dash-orlando/AugmentedStethoscope/Software/Sound Library/YouTube Videos/YouTube Videos.docx

https://www.youtube.com/watch?v=bHXvhOQ0hYc

https://www.youtube.com/watch?v=UfCr_wUepxo

https://www.youtube.com/watch?v=MCtoqxRfBi4

https://www.youtube.com/watch?v=KnYfreaRQe4

YouTube Videos Blood Pressure Sounds
