dash-orlando/AugmentedStethoscope/Documentation/Conferences/DMD/2018/paper_figures.pptx

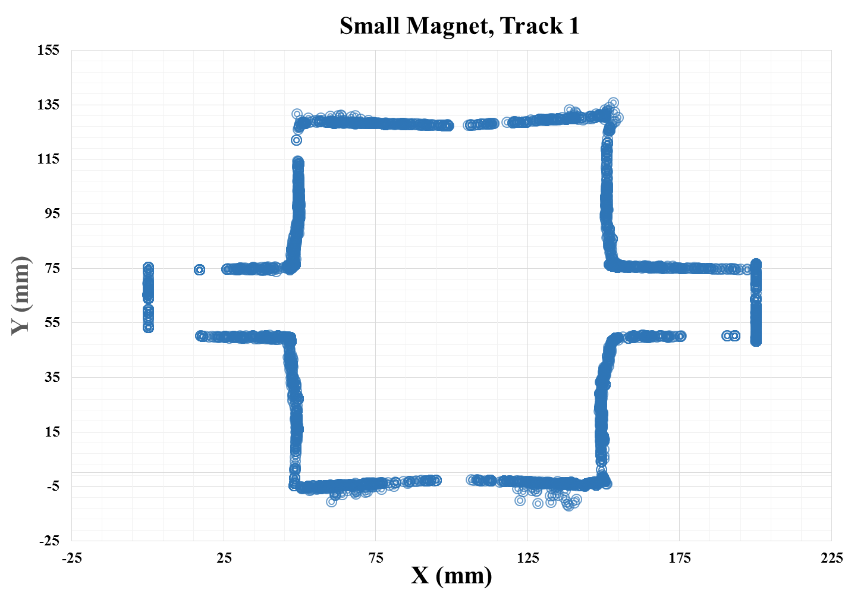
[picture p10: figure]
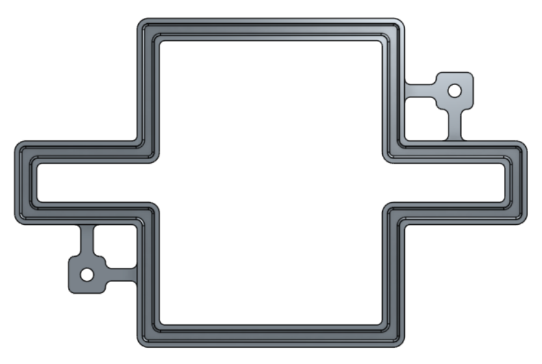
[picture p11: figure]

## Slide 2

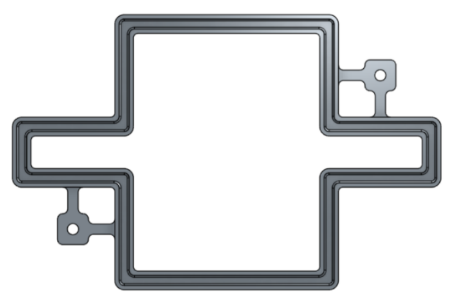
[picture p12: figure]

## Slide 3

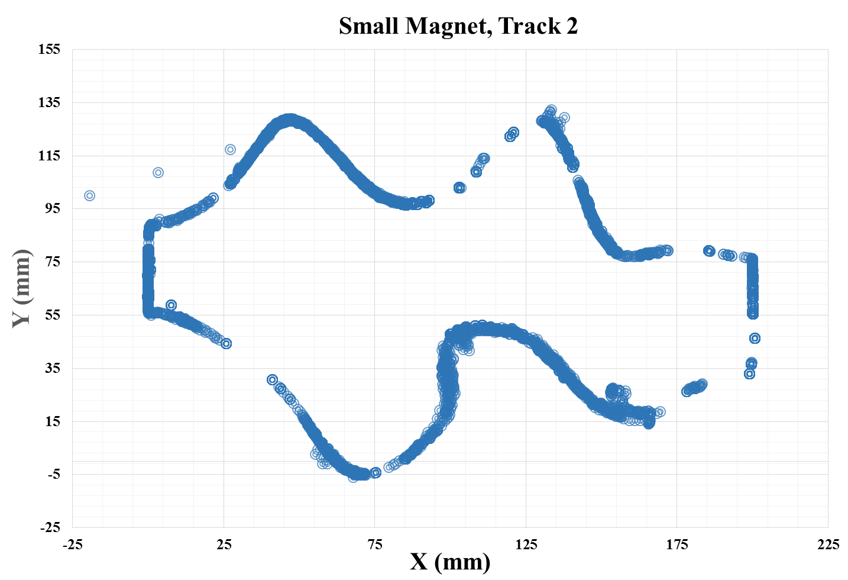
[picture p13: figure]
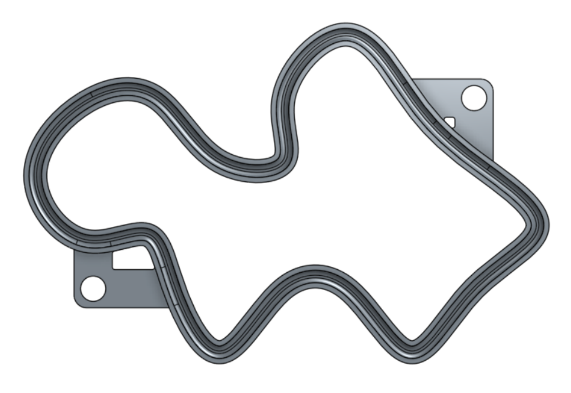
[picture p14: figure]

## Slide 4

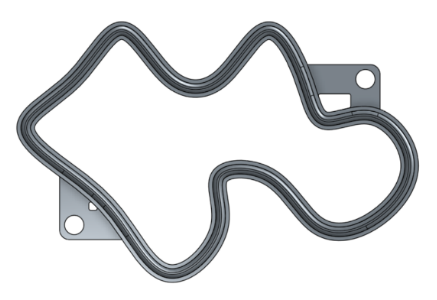
[picture p15: figure]
