dash-orlando/AugmentedStethoscope/Hardware/STET003/List of Stethoscopes.xlsx

Stethoscope Number | BT MAC | Hardware | Software
STET001 | 0006668CD3F6 | v3 | 2018-03-27
STET002 | 0006668C9C2E | v3 | 2018-03-27
STET003 | 000666D0E437 | v3 | 2018-03-27
STET004 | 000666D0C9A5 | v3.5 | 2018-03-27
STET005 |  | v3.5 | 2018-03-27
STET006 |  | v3 | 2018-03-27
STET007 |  | v3 | 2018-03-27
STET008 |  | v3 | 2018-03-27
STET009 |  | v3 | 2018-03-27
STET010 |  | v3 | 2018-03-27
