dash-orlando/AugmentedStethoscope/Documentation/Conferences/DMD/2018/curved_track_1_solid.png

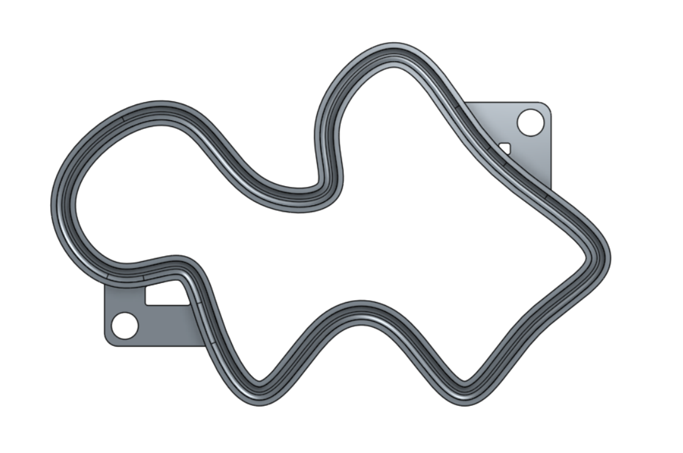
Documentation/Conferences/DMD/2018/curved_track_1_solid.png
