dash-orlando/AugmentedStethoscope/Documentation/Conferences/DMD/2018/point_accuracy_tracking_1.JPG

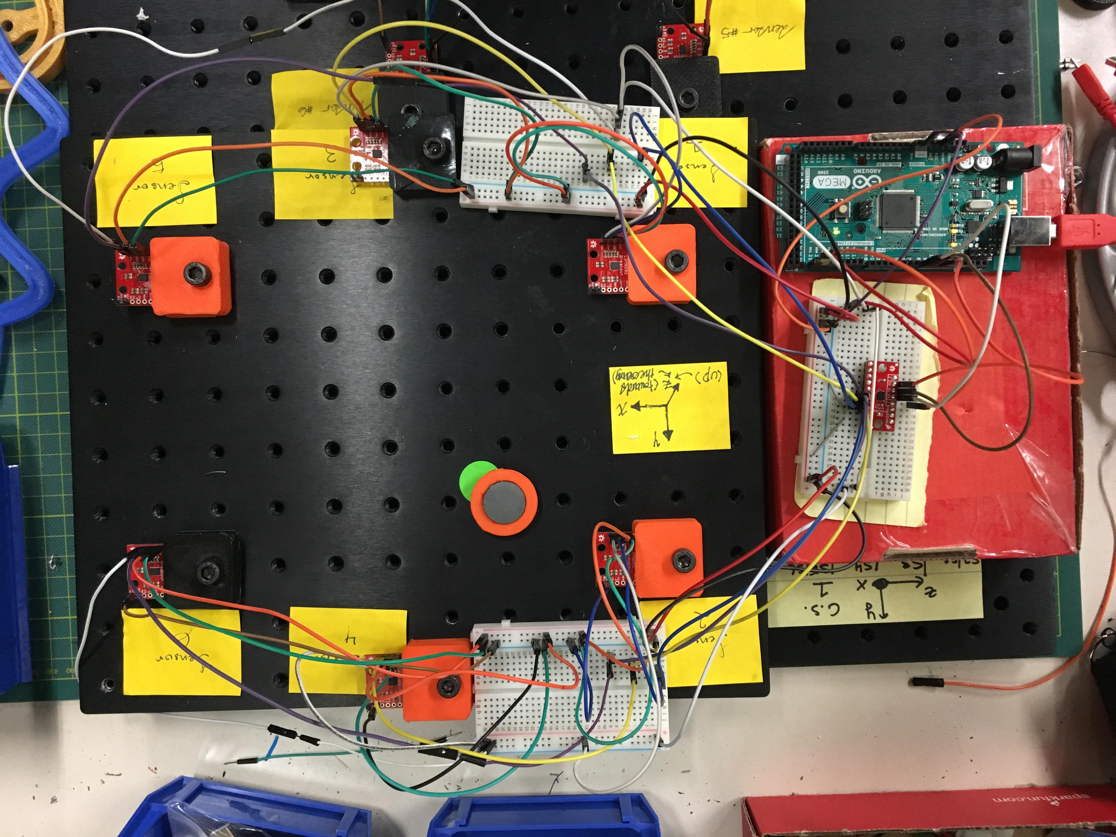
Documentation/Conferences/DMD/2018/point_accuracy_tracking_1.JPG
