dash-orlando/AugmentedStethoscope/Documentation/Conferences/DMD/2018/square_track_1.png

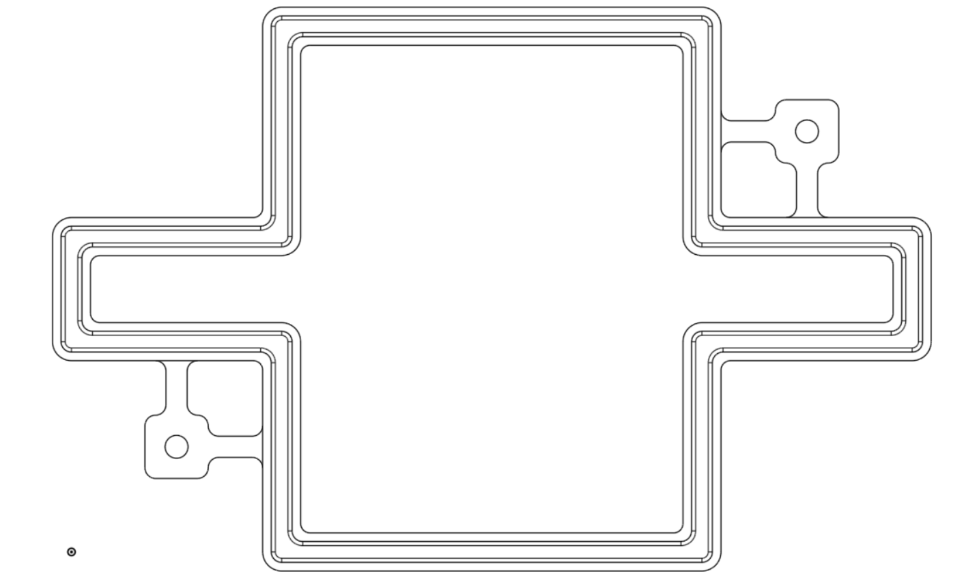
Documentation/Conferences/DMD/2018/square_track_1.png
