dash-orlando/AugmentedStethoscope/Documentation/Features/Media/full_diagram_11092017.png

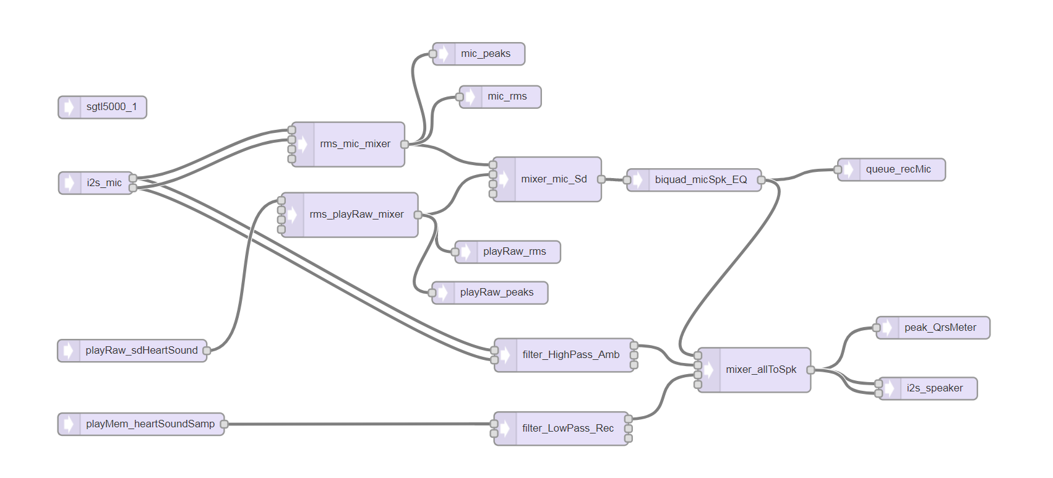
Documentation/Features/Media/full_diagram_11092017.png
