dash-orlando/AugmentedStethoscope/Hardware/STET002/PCB/AudioShield.png

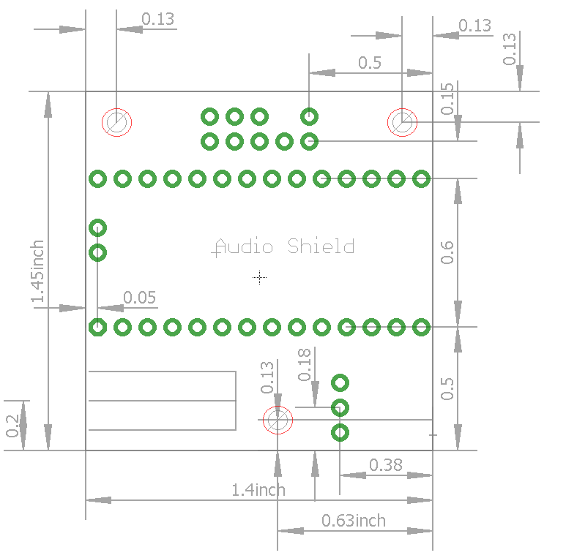
Hardware/STET002/PCB/AudioShield.png
