dash-orlando/AugmentedStethoscope/Hardware/STET002/PCB/Fritzing/STET002_pcb.jpg

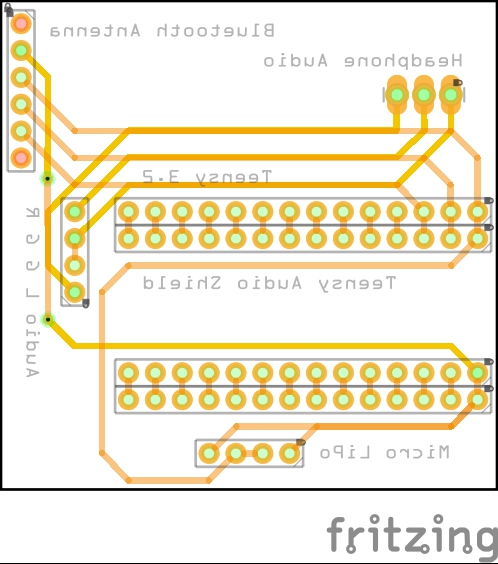
Hardware/STET002/PCB/Fritzing/STET002_pcb.jpg
