dash-orlando/AugmentedStethoscope/Hardware/STET002/PCB/Fritzing/STET002_pcb.png

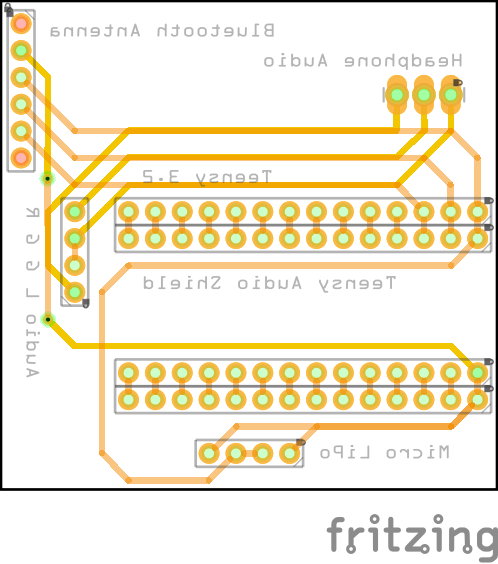
Hardware/STET002/PCB/Fritzing/STET002_pcb.png
