dash-orlando/AugmentedStethoscope/Hardware/STET004/Estimates/STET004 PCB.PNG

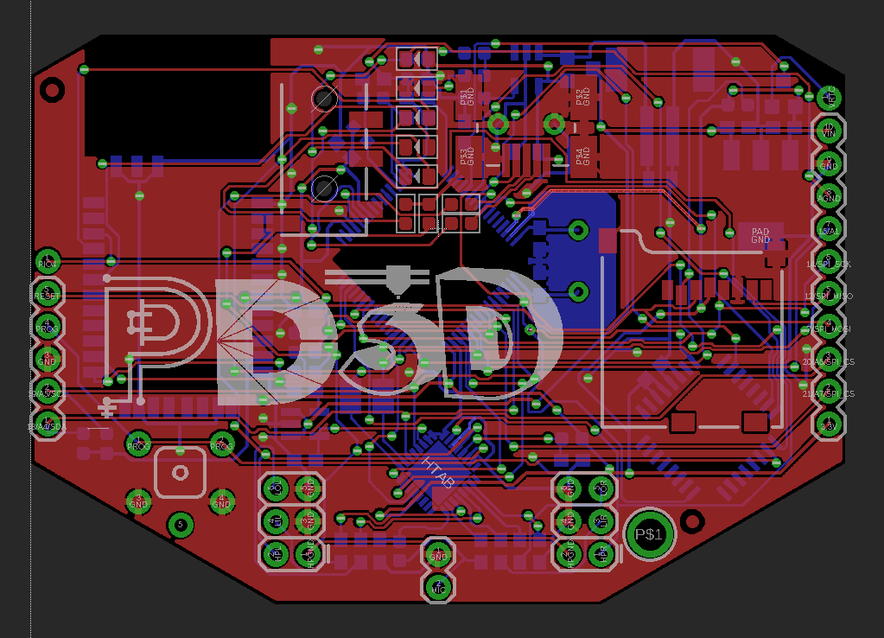
Hardware/STET004/Estimates/STET004 PCB.PNG
