dash-orlando/AugmentedStethoscope/Documentation/BOM/Augmented Stethoscope BOM.xlsx

Component | ID | Description | Justification | Link | Unit Cost | Quantity | Total Cost
Acoustic Tubing | TUBING | 30cm Large tubing; 5cm small tubing | Stethoscope Project: Acoustic conduit from speakers to stethoscope tubing connector | https://diyearphone.com/products/acoustic-tubing | $10.00 | 0.00 | $0.00
400 mAh LiPo Battery | PRT-13112 | 110 mAh, 3.7v Lithium-polymer battery | Stethoscope Project: Component power | https://www.adafruit.com/product/1578 | $7.95 | 1.00 | $7.95
Adafruit Micro Lipo charger | ADA-1904 | LiPo charger module | Stethoscope Project: Circuit board power source and battery charging | https://www.adafruit.com/product/1904 | $6.95 | 1.00 | $6.95
Dynamat Xtreme | 10425 | 18" x 32" x 0.067" Sheet sound-absorbing material | Stethoscope Project: Stethoscope-housing inner liner for external sound damping | https://www.amazon.com/Dynamat-10425-Self-Adhesive-Deadener-Xtreme/dp/B00020CAVA | $24.41 | 0.00 | $0.00
MDF Stethoscope | MDF747BO | Dual-head stethoscope | Stethoscope Project: Integral/donor components | https://www.amazon.com/MDF-Dual-Head-Lightweight-Stethoscope/dp/B000RL1KVA?s=hpc | $13.51 | 1.00 | $13.51
SanDisk Ultra 16GB Ultra Micro SDHC UHS-I/Class 10 Card | SDSQUNC-016G-GN6MA | SD storage memory card | Stethoscope Project: Audio data storage (samples and recording) | https://www.amazon.com/SanDisk-Ultra-Micro-Adapter-SDSQUNC-016G-GN6MA/dp/B010Q57SEE?s=pc | $10.04 | 1.00 | $10.04
24 AWG Fine-strand Tinned Copper Silicone Wire | WS24AWG-25RBY-F | 24-gauge Silicone-insulated wire | Stethoscope Project: Speaker-to-PCB interconnection | https://www.amazon.com/Silicone-Wire-Strand-Gauge-Yellow/dp/B019Q1A57G | $24.99 | 0.00 | $0.00
CUI-Inc. CMA-4544PF-W Microphone | 102-1721-ND | Electret condenser mic with washer | Stethoscope Project: Integral/sound input-transducer | https://www.digikey.com/product-detail/en/cui-inc/CMA-4544PF-W/102-1721-ND/1869981 | $0.57 | 1.00 | $0.57
Acoustic Damper - Red - 2200Ω | 423-1184-ND | Sound-wave damper/filter; cloth in metalic cylinder (woofer lowpass) | Stethoscope Project: Heartbeat sound conditioning; high-freq limitting | https://www.digikey.com/product-detail/en/knowles/BF-1921-000/423-1184-ND/810394 | $1.43 | 1.00 | $1.43
Knowles Balanced Armature Speaker | 423-1147-ND | 37-ohm Balanced-armature speaker | Stethoscope Project: Integral/sound output-transducer | https://www.digikey.com/product-detail/en/knowles/GQ-30783-000/423-1147-ND/2686690 | $34.07 | 1.00 | $34.07
Individual, Through-hole Pogo Pin | ED1652-ND | Low-profile individual Spring piston connector | Stethoscope Project: Teensy audio board audio output to interface PCB connection | https://www.digikey.com/products/en?keywords=0926-1-15-20-75-14-11-0 | $1.19 | 3.00 | $3.57
2mm Pitch, Single Row, Through-hole Pogo Pins | ED10874-ND | 2mm-pitch 2 -position Spring piston connector | Stethoscope Project: Speaker interconnection to BA speaker connection pads | https://www.digikey.com/products/en?keywords=mil-max%20836-22-002-10 | $1.94 | 1.00 | $1.94
Connector Pin Rcpt .015-.022, Solder end | ED10651-ND | Pin receptacle connector 0.015" ~ 0.022" (0.38mm ~ 0.56mm) No tail solder | Stethoscope Project: Speaker enclosure-to-wire interconnection | https://www.digikey.sg/products/en?keywords=mil-max%204485-0-51-15-21-27-10-0 | $0.80 | 2.00 | $1.60
Teensy Audio Shield | TEENSY3_AUDIO | Audio processing board | Stethoscope Project: Integral/acousitcs signal processor | https://www.pjrc.com/store/teensy3_audio.html | $14.25 | 1.00 | $14.25
Teensy 3.2 USB Board | TEENSY32 | Microcontroller | Stethoscope Project: Integral/process controller | https://www.pjrc.com/store/teensy32.html | $19.80 | 1.00 | $19.80
SparkFun Bluetooth Modem - BlueSMiRF Silver | WRL-12577 | Bluetooth antenna | Stethoscope Project: Bluetooth communication link to other devices | https://www.sparkfun.com/products/12577 | $24.95 | 1.00 | $24.95
Speaker enclosure (3D printed) |  | Speaker mounting to housing |  |  |  | 1.00
Microphone enclosure (3D printed) |  | Mic mounting to housing |  |  |  | 1.00
Stethoscope electronics housing (3D printed) |  | Housing/case for component set |  |  |  | 1.00
Component interface board (PCB) |  | Interfaces component circuit boards |  |  |  | 1.00
 |  |  |  | Total = |  | 20.00 | $140.63
