dash-orlando/AugmentedStethoscope/Hardware/STET004/Estimates/47825A1_BOM_VK_2018-04-02.xlsx

Sheet: BOM
MOUSER
Part No. | Schematic ID | Type | Description | Package | Manufacturer | Manufacturer Part No. | Mouser Part No. | Unit Price | Quantity | Total Price | Reference
1 | C3, C4 | Capacitor | 22pF / 50VDC / C0G (NP0) | 603 | Murata Electronics | GCM1885C1H220FA16J | 81-GCM1885C1H220FA6J | $0.17 | 2 | $0.34 | https://www.mouser.com/datasheet/2/281/c03e-516224.pdf
2 | C1, C2, C5, C6, C8, C9, C10, C11, C16 | Capacitor | 0.1uF / 25VDC / X5R | 603 | Taiyo Yuden | GMK063BJ104KP-F | 963-GMK063BJ104KP-F | $0.14 | 8 | $1.12 | https://www.mouser.com/datasheet/2/396/mlcc02_e-1307760.pdf
3 | C15 | Capacitor | 0.15uF / 25VDC / X5R | 603 | Taiyo Yuden | TMK107BJ154KA-T | 963-TMK107BJ154KA-T | $0.25 | 1 | $0.25 | ^
4 | C7, C11, 12, C13, C14, C17, C18, C21, C22, C23 | Capacitor | 2.2uF / 25 VDC / X6S | 603 | Taiyo Yuden | TMK107BC6225KA-T | 963-TMK107BC6225KA-T | $0.32 | 10 | $3.20 | ^
5 | C19, C20 | Capacitor | 10uF / 25VDC / X5R | 805 | Taiyo Yuden | TMK212BBJ106KD-T | 963-TMK212BBJ106KD-T | $0.39 | 2 | $0.78 | ^
6 | X1 | Connector | MINI USB | 5PN | MOLEX | 675031020 | 538-67503-1020 | $0.65 | 1 | $0.65 | https://www.mouser.com/datasheet/2/276/0675031020_IO_CONNECTORS-172123.pdf
7 | G1 | Crystal | 16MHz / 18pF / 10ppm | HC-49US | ABRACON | ABL-16.000MHz-B1U | 815-ABL-16-B1U | $0.47 | 1 | $0.47 | https://www.mouser.com/datasheet/2/3/ABL-10083.pdf
8 | R5, R18 | Diode | Dual Schottky, Common | SOT-23 | Nexperia | BAT54C,215 | 771-BAT54C-T/R | $0.24 | 2 | $0.48 | https://www.mouser.com/datasheet/2/302/BAT54_SER-1149775.pdf
9 | R10, R12, R20 | Ferrite | 600R / 100MHz | 603 | Murata Electronics | BLM18AG601SN1D | 81-BLM11A601S | $0.10 | 3 | $0.30 | https://www.mouser.com/datasheet/2/281/c31e-794748.pdf
10 | P5 | LED | Red LED | 805 | Kingbright | APTD2012LSURCK | 604-APTD2012LSURCK | $0.33 | 1 | $0.33 | https://www.mouser.com/datasheet/2/216/APTD2012LSURCK-1101937.pdf
11 | P4 | LED | Green LED | 805 | Kingbright | APTD2012LZGCK | 604-APTD2012LZGCK | $0.68 | 1 | $0.68 | https://www.mouser.com/datasheet/2/216/APTD2012LZGCK-1101817.pdf
12 | P1, P2, P3 | LED | Blue LED | 805 | Kingbright | APTD2012LQBC/D | 604-APTD2012LQBCD | $0.46 | 3 | $1.38 | https://www.mouser.com/datasheet/2/216/APTD2012LQBC-D-1102003.pdf
13 | K2 | Microcontroller | MK20DX256VLH7 | LQFP-64 | NXP | MK20DX256VLH7 | 841-MK20DX256VLH7 | $7.10 | 1 | $7.10 | https://www.mouser.com/datasheet/2/302/K20P64M72SF1-1126422.pdf
14 | R7, R8 | Resistor | 33 / 1% / 0.25 W | 603 | Panasonic | ERJ-PA3F33R0V | 667-ERJ-PA3F33R0V | $1.23 | 2 | $2.46 | https://www.mouser.com/datasheet/2/315/AOA0000C331-1141874.pdf
15 | R1, R2, R3, R4, R11, R15, R17 | Resistor | 470 / 0.5% / 0.25 W | 603 | Panasonic | ERJ-PA3D4700V | 667-ERJ-PA3D4700V | $0.37 | 7 | $2.59 | ^
16 | R13, R16 | Resistor | 2.2K / 0.5% / 0.25W | 603 | Panasonic | ERJ-PA3D2201V | 667-ERJ-PA3D2201V | $0.37 | 2 | $0.74 | ^
17 | R6, R9, R14, R19, R21 | Resistor | 10K / 0.5 % / 0.25W | 603 | Panasonic | ERJ-PA3D1002V | 667-ERJ-PA3D1002V | $0.37 | 5 | $1.85 | ^
18 | S1 | Tactile Switch | SPST | 6x6x5 MM | ALPS | SKHHPKA010 | 688-SKHHPK | $0.31 | 1 | $0.31 | http://www.alps.com/prod/info/E/PDF/Tact/SnapIn/SKHH/SKHHPKA010.pdf
19 | U2 | LIPO Charger | Battery Management Controller | SOT-23-5 | Microchip Technology | MCP73831T-2ACI/OT | 579-MCP73831T-2ACIOT | $0.68 | 1 | $0.68 | https://www.mouser.com/datasheet/2/268/20001984g-846362.pdf
20 | U3 | Audio Codec | Audio Codex Interface | QFN-32 | NXP | SGTL5000XNAA3R2 | 841-SGTL5000XNAA3R2 | $2.82 | 1 | $2.82 | https://www.mouser.com/datasheet/2/302/SGTL5000-1127744.pdf
21 | U4 | Voltage Regulator | 1.8V 200mA | SOT-23-5 | Texas Instruments | TPS79318DBVR | 595-TPS79318DBVR | $0.73 | 1 | $0.73 | http://www.ti.com/lit/gpn/tps793
22 | T1 | Voltage Regulator | 3.3V 500mA | SOT-223-3 | Microchip Technology | MCP1825S-3302E/DB | 579-MCP1825S-3302EDB | $0.62 | 1 | $0.62 | https://www.mouser.com/datasheet/2/268/22056b-475378.pdf
MOUSER ELECTRONICS TOTAL: |  |  |  |  |  |  |  |  | 57 | $29.88
SPARKFUN
Part No. | Schematic ID | Type | Description | Package | Manufacturer | Manufacturer Part No. | SparkFun Product No. | Unit Price | Quantity | Total Price | Reference:
23 | U1 | Connector | MicroSD Transflash Socket | SPI uSD SMD/SMT | 4UCON Technology Inc | 15882 T-FLASH-CON | PRT-00127 | $3.95 | 1 | $3.95 | https://www.sparkfun.com/products/127
24 | J6 | Connector | 3.5mm Audio Jack TRSS | 3.5MM TRSS SMD/SMT | 4UCON Technology Inc | 20153 TRSS-CON | PRT-12639 | $0.95 | 1 | $0.95 | https://www.sparkfun.com/products/12639
25 | J7 | Connector | JST Right Angle Connector | JST 2-Pin SMD/SMT | 4UCON Technology Inc | 17311 JSTPH-CON | PRT-08612 | $0.95 | 1 | $0.95 | https://www.sparkfun.com/products/8612
SPARKFUN TOTAL: |  |  |  |  |  |  |  |  | 3 | $5.85
PJRC
Part No. | Schematic ID | Type | Description | Package | Manufacturer | Manufacturer Part No. |  | Unit Price | Quantity | Total Price | Reference:
26 | K1 | Bootloader | MKL04Z32VLC4 (Preprogrammed) | LQFP-32 | PJRC | IC_MKL04Z32_TQFP32 |  | $6.95 | 1 | $6.95 | https://www.pjrc.com/store/ic_mkl02.html
PJRC TOTAL: |  |  |  |  |  |  |  |  | 1 | $6.95
COMPONENTS TOTAL: |  |  |  |  |  |  |  |  | 61 | $42.68

Sheet: 47825A1_VK
Part No. | Schematic ID | Type | Description | Package | Manufacturer | Manufacturer Part No. | Mouser Part No. | Unit Price | Quantity | Total Price | Reference | Qty'200 | $200 | _$200 | Available | MOQ | Supplier_VK | Production P/N_VK | Supplier P/N_VK | Production MFG_VK | Production Description_VK | Comments_VK | Your Comments
1 | C3, C4 | Capacitor | 22pF / 50VDC / C0G (NP0) | 603 | Murata Electronics | GCM1885C1H220FA16J | 81-GCM1885C1H220FA6J | $0.17 | 2 | $0.34 | https://www.mouser.com/datasheet/2/281/c03e-516224.pdf | 400 | 0.05780 | 0.11560 | 3373 | 1 | Digi-Key | GCM1885C1H220FA16J | 490-14354-1-ND | Murata Manufacturing Co Ltd | CAP CER 22PF 50V C0G/NP0 0603
2 | C1, C2, C5, C6, C8, C9, C10, C11, C16 | Capacitor | 0.1uF / 25VDC / X5R | 603 | Taiyo Yuden | GMK063BJ104KP-F | 963-GMK063BJ104KP-F | $0.14 | 8 | $1.12 | https://www.mouser.com/datasheet/2/396/mlcc02_e-1307760.pdf | 1600 | 0.03410 | 0.27280 | 17899 | 1 | Digi-Key | GMK063BJ104KP-F | 587-6007-1-ND | TAIYO YUDEN | CAP CER 0.1UF 35V X5R 0201 | There are 9 reference designators given in column"B" but the qty given in column"J" is 8.Please comment. & The description in column" D, E" refers to "35V & 0603" whereas online description refers to "35V & 0201".Please comment.
3 | C15 | Capacitor | 0.15uF / 25VDC / X5R | 603 | Taiyo Yuden | TMK107BJ154KA-T | 963-TMK107BJ154KA-T | $0.25 | 1 | $0.25 | ^ | 200 | 0.04100 | 0.04100 | 16000 | 1 | Mouser | TMK107BJ154KA-T | 963-TMK107BJ154KA-T | TAIYO YUDEN | Multilayer Ceramic Capacitors MLCC - SMD/SMT 0.15uF 25V X5R +/-10% 0603 Gen Purp
4 | C7, C11, 12, C13, C14, C17, C18, C21, C22, C23 | Capacitor | 2.2uF / 25 VDC / X6S | 603 | Taiyo Yuden | TMK107BC6225KA-T | 963-TMK107BC6225KA-T | $0.32 | 10 | $3.20 | ^ | 2000 | 0.09270 | 0.92700 | 6873 | 1 | Digi-Key | TMK107BC6225KA-T | 587-4930-1-ND | TAIYO YUDEN | CAP CER 2.2UF 25V X6S 0603
5 | C19, C20 | Capacitor | 10uF / 25VDC / X5R | 805 | Taiyo Yuden | TMK212BBJ106KD-T | 963-TMK212BBJ106KD-T | $0.39 | 2 | $0.78 | ^ | 400 | 0.13400 | 0.26800 | 0 | 1 | Mouser | TMK212BBJ106KD-T | 963-TMK212BBJ106KD-T | TAIYO YUDEN | Multilayer Ceramic Capacitors MLCC - SMD/SMT 10uF 25V X5R 10% 0805 | No stock is available with vendors.Please provide an alternate P/N
6 | X1 | Connector | MINI USB | 5PN | MOLEX | 675031020 | 538-67503-1020 | $0.65 | 1 | $0.65 | https://www.mouser.com/datasheet/2/276/0675031020_IO_CONNECTORS-172123.pdf | 200 | 0.77830 | 0.77830 | 9176 | 1 | Digi-Key | 675031020 | WM5461CT-ND | Molex | CONN RECEPT MINIUSB R/A 5POS SMD
7 | G1 | Crystal | 16MHz / 18pF / 10ppm | HC-49US | ABRACON | ABL-16.000MHz-B1U | 815-ABL-16-B1U | $0.47 | 1 | $0.47 | https://www.mouser.com/datasheet/2/3/ABL-10083.pdf | 200 | 0.31500 | 0.31500 | 573 | 1 | Mouser | ABL-16.000MHz-B1U | 815-ABL-16-B1U | Abracon Corporation | Crystals 16.000MHZ, 18pF 10ppm -20C +70C
8 | R5, R18 | Diode | Dual Schottky, Common | SOT-23 | Nexperia | BAT54C,215 | 771-BAT54C-T/R | $0.24 | 2 | $0.48 | https://www.mouser.com/datasheet/2/302/BAT54_SER-1149775.pdf | 400 | 0.05900 | 0.11800 | 3516 | 1 | Newark | BAT54C,215 |  | NEXPERIA | Small Signal Schottky Diode, Dual Common Cathode, 40 V, 100 mA, 800 mV, 600 mA, 150 °C
9 | R10, R12, R20 | Ferrite | 600R / 100MHz | 603 | Murata Electronics | BLM18AG601SN1D | 81-BLM11A601S | $0.10 | 3 | $0.30 | https://www.mouser.com/datasheet/2/281/c31e-794748.pdf | 600 | 0.03170 | 0.09510 | 680706 | 1 | Digi-Key | BLM18AG601SN1D | 490-1014-1-ND | Murata Manufacturing Co Ltd | FERRITE BEAD 600 OHM 0603 1LN
10 | P5 | LED | Red LED | 805 | Kingbright | APTD2012LSURCK | 604-APTD2012LSURCK | $0.33 | 1 | $0.33 | https://www.mouser.com/datasheet/2/216/APTD2012LSURCK-1101937.pdf | 200 | 0.19710 | 0.19710 | 2595 | 1 | Digi-Key | APTD2012LSURCK | 754-2044-1-ND | Kingbright | LED RED CLEAR SMD
11 | P4 | LED | Green LED | 805 | Kingbright | APTD2012LZGCK | 604-APTD2012LZGCK | $0.68 | 1 | $0.68 | https://www.mouser.com/datasheet/2/216/APTD2012LZGCK-1101817.pdf | 200 | 0.40040 | 0.40040 | 329 | 1 | Digi-Key | APTD2012LZGCK | 754-2048-1-ND | Kingbright | LED GREEN CLEAR 2SMD
12 | P1, P2, P3 | LED | Blue LED | 805 | Kingbright | APTD2012LQBC/D | 604-APTD2012LQBCD | $0.46 | 3 | $1.38 | https://www.mouser.com/datasheet/2/216/APTD2012LQBC-D-1102003.pdf | 600 | 0.22260 | 0.66780 | 2945 | 1 | Digi-Key | APTD2012LQBC/D | 754-2046-1-ND | Kingbright | LED BLUE CLEAR SMD
13 | K2 | Microcontroller | MK20DX256VLH7 | LQFP-64 | NXP | MK20DX256VLH7 | 841-MK20DX256VLH7 | $7.10 | 1 | $7.10 | https://www.mouser.com/datasheet/2/302/K20P64M72SF1-1126422.pdf | 200 | 5.85620 | 5.85620 | 13748 | 1 | Digi-Key | MK20DX256VLH7 | MK20DX256VLH7-ND | NXP Semiconductors | IC MCU 32BIT 256KB FLASH 64LQFP
14 | R7, R8 | Resistor | 33 / 1% / 0.25 W | 603 | Panasonic | ERJ-PA3F33R0V | 667-ERJ-PA3F33R0V | $1.23 | 2 | $2.46 | https://www.mouser.com/datasheet/2/315/AOA0000C331-1141874.pdf | 400 | 0.04700 | 0.09400 | 0 | 1 | Mouser | ERJ-PA3F33R0V | 667-ERJ-PA3F33R0V | Panasonic Electronic Components | Thick Film Resistors - SMD 0603 33ohm 1% Anti-Surge AEC-Q200 | No stock is available with vendors.Please provide an alternate P/N
15 | R1, R2, R3, R4, R11, R15, R17 | Resistor | 470 / 0.5% / 0.25 W | 603 | Panasonic | ERJ-PA3D4700V | 667-ERJ-PA3D4700V | $0.37 | 7 | $2.59 | ^ | 1400 | 0.04600 | 0.32200 | 4003 | 1 | Mouser | ERJ-PA3D4700V | 667-ERJ-PA3D4700V | Panasonic Electronic Components | Thick Film Resistors - SMD 0603 470ohm 0.5% Anti-Surge AEC-Q200
16 | R13, R16 | Resistor | 2.2K / 0.5% / 0.25W | 603 | Panasonic | ERJ-PA3D2201V | 667-ERJ-PA3D2201V | $0.37 | 2 | $0.74 | ^ | 400 | 0.06300 | 0.12600 | 0 | 1 | Mouser | ERJ-PA3D2201V | 667-ERJ-PA3D2201V | Panasonic Electronic Components | Thick Film Resistors - SMD 0603 2.2Kohm 0.5% Anti-Surge AEC-Q200 | No stock is available with vendors.Please provide an alternate P/N
17 | R6, R9, R14, R19, R21 | Resistor | 10K / 0.5 % / 0.25W | 603 | Panasonic | ERJ-PA3D1002V | 667-ERJ-PA3D1002V | $0.37 | 5 | $1.85 | ^ | 1000 | 0.04600 | 0.23000 | 2539 | 1 | Mouser | ERJ-PA3D1002V | 667-ERJ-PA3D1002V | Panasonic Electronic Components | Thick Film Resistors - SMD 0603 10Kohm 0.5% Anti-Surge AEC-Q200
18 | S1 | Tactile Switch | SPST | 6x6x5 MM | ALPS | SKHHPKA010 | 688-SKHHPK | $0.31 | 1 | $0.31 | http://www.alps.com/prod/info/E/PDF/Tact/SnapIn/SKHH/SKHHPKA010.pdf | 200 | 0.23100 | 0.23100 | 3582 | 1 | Mouser | SKHHPKA010 | 688-SKHHPK | Alps Electric Co Ltd | Tactile Switches 6.0x6.0x5.0mm 100gf
19 | U2 | LIPO Charger | Battery Management Controller | SOT-23-5 | Microchip Technology | MCP73831T-2ACI/OT | 579-MCP73831T-2ACIOT | $0.68 | 1 | $0.68 | https://www.mouser.com/datasheet/2/268/20001984g-846362.pdf | 200 | 0.44520 | 0.44520 | 75774 | 1 | Digi-Key | MCP73831T-2ACI/OT | MCP73831T-2ACI/OTCT-ND | Microchip Technology Inc | IC CONTROLLR LI-ION 4.2V SOT23-5
20 | U3 | Audio Codec | Audio Codex Interface | QFN-32 | NXP | SGTL5000XNAA3R2 | 841-SGTL5000XNAA3R2 | $2.82 | 1 | $2.82 | https://www.mouser.com/datasheet/2/302/SGTL5000-1127744.pdf | 200 | 2.08470 | 2.08470 | 16758 | 1 | Digi-Key | SGTL5000XNAA3R2 | SGTL5000XNAA3R2CT-ND | NXP Semiconductors | IC AUDIO CODEC STEREO 32-QFN
21 | U4 | Voltage Regulator | 1.8V 200mA | SOT-23-5 | Texas Instruments | TPS79318DBVR | 595-TPS79318DBVR | $0.73 | 1 | $0.73 | http://www.ti.com/lit/gpn/tps793 | 200 | 0.50550 | 0.50550 | 8441 | 1 | Digi-Key | TPS79318DBVR | 296-12155-1-ND | Texas Instruments | IC REG LINEAR 1.8V 200MA SOT23-5
22 | T1 | Voltage Regulator | 3.3V 500mA | SOT-223-3 | Microchip Technology | MCP1825S-3302E/DB | 579-MCP1825S-3302EDB | $0.62 | 1 | $0.62 | https://www.mouser.com/datasheet/2/268/22056b-475378.pdf | 200 | 0.41340 | 0.41340 | 10300 | 1 | Digi-Key | MCP1825S-3302E/DB | MCP1825S-3302E/DB-ND | Microchip Technology Inc | IC REG LIN 3.3V 500MA SOT223-3
23 | U1 | Connector | MicroSD Transflash Socket | SPI uSD SMD/SMT | 4UCON Technology Inc | 15882 T-FLASH-CON | PRT-00127 | $3.95 | 1 | $3.95 | https://www.sparkfun.com/products/127 | 200 | 3.56000 | 3.56000 | 250 | 1 | Sparkfun | PRT-00127 |  | SparkFun Electronics | SparkFun Accessories microSD Socket for Transflash
24 | J6 | Connector | 3.5mm Audio Jack TRSS | 3.5MM TRSS SMD/SMT | 4UCON Technology Inc | 20153 TRSS-CON | PRT-12639 | $0.95 | 1 | $0.95 | https://www.sparkfun.com/products/12639 | 200 | 0.86000 | 0.86000 | 250 | 1 | Sparkfun | PRT-12639 |  | SparkFun Electronics | SparkFun Accessories Audio Jack - 3.5mm TRRS (SMD)
25 | J7 | Connector | JST Right Angle Connector | JST 2-Pin SMD/SMT | 4UCON Technology Inc | 17311 JSTPH-CON | PRT-08612 | $0.95 | 1 | $0.95 | https://www.sparkfun.com/products/8612 | 200 | 0.95000 | 0.95000 | 709 | 1 | Mouser | PRT-08612 | 474-PRT-08612 | SparkFun Electronics | SparkFun Accessories JST Right Angle Connector - White
26 | K1 | Bootloader | MKL04Z32VLC4 (Preprogrammed) | LQFP-32 | PJRC | IC_MKL04Z32_TQFP32 |  | $6.95 | 1 | $6.95 | https://www.pjrc.com/store/ic_mkl02.html | 200 | 6.95000 | 6.95000 |  | 1 | PJRC | IC_MKL04Z32_TQFP32 |  | PJRC | MKL04 chip with pre-programmed Teensy LC, 3.2, 3.5, 3.6 bootloader
 |  |  |  |  |  |  |  |  |  |  |  | Sub-Total |  | 26.82410
 |  |  |  |  |  |  |  |  |  |  |  | Production Loss |  | 0.26824
 |  |  |  |  |  |  |  |  |  |  |  | Supplier Shipping Cost |  | 0.00000
 |  |  |  |  |  |  |  |  |  |  |  | PARTS TOTAL |  | 27.09234
