dash-orlando/AugmentedStethoscope/Documentation/Assembly Guides/Stethoscope Assembly - Assembly Components.xlsx

Component | ID | Description | Justification | Link | Unit Cost | Quantity | Total Cost | Ordered | Delivered
Stethoscope | N.A. | Standard Stethsocope | Needed to assembly electronic stethoscope | https://www.amazon.com/MDF-Dual-Head-Lightweight-Stethoscope/dp/B000RL1KVA?s=hpc | $13.51 | 1.00 | $13.51
Headphones | N.A. | Standard headphones | Needed as spekers to replay sounds captured by the microphone | https://www.amazon.com/Panasonic-Headphones-RP-HJE120-K-Ergonomic-Comfort-Fit/dp/B003EM8008 | $7.79 | 1.00 | $7.79
Stethoscope Hosuing | N.A. | Plastic housing and other parts | Needed to enclose electronics and seal electronic stethoscope |  | $50.00 | 1.00 | $50.00
Stethoscope PCB | N.A. | Prepared PCB | Needed as the consolidated electronics of the stethoscope |  | $80.00 | 1.00 | $80.00
 |  |  |  |  |  | Total | $151.30
