dash-orlando/AugmentedStethoscope/Documentation/Assembly Guides/Stethoscope Assembly - Lab Components.xlsx

Component | ID | Description | Justification | Link | Unit Cost | Quantity | Total Cost | Ordered | Delivered
Weller Soldering Station |  | Solder Station | Needed to solder wires, pin and electrincal components | https://www.amazon.com/Weller-WLC100-40-Watt-Soldering-Station/dp/B000AS28UC?s=hi | $38.63 | 1.00 | $38.63
Vastar Solder Sucker |  | Desoldering Vacuum | Needed to remove solder | https://www.amazon.com/Vastar-Solder-Sucker-Desoldering-Removal/dp/B01C70X7V4?s=hi | $6.99 | 1.00 | $6.99
Helping Hand |  | Helping Hand | Needed to hold parts and components while soldering | https://www.amazon.com/gp/product/B000RB38X8 | $6.59 | 1.00 | $6.59
Solder Tip Cleaning Wire |  | Cleaning Wire | Needed to clean the tip of the solder iron | https://www.amazon.com/gp/product/B00FZPGDLA | $9.14 | 1.00 | $9.14
0.6 mm Solder Wire |  | Solder Wire | Needed to solder components | https://www.amazon.com/Mudder-0-6mm-Ag0-3-0-22lb-Solder/dp/B01B61TWGY?s=hi | $12.59 | 1.00 | $12.59
Rosin Paste Flux |  | Flux | Needed to enhance the soldering process | https://www.amazon.com/gp/product/B008ZIV85A | $10.70 | 1.00 | $10.70
Hakko Wire Cutter |  | Wire Cutter | Needed to cut wires and other components | https://www.amazon.com/gp/product/B00FZPDG1K | $4.47 | 1.00 | $4.47
 |  |  |  |  |  | Total | $89.11
