dash-orlando/AugmentedStethoscope/Documentation/Assembly Guides/Stethoscope Assembly - Preparation Components.xlsx

Component | ID | Description | Justification | Link | Unit Cost | Quantity | Total Cost | Ordered | Delivered
Teensy 3.2 | N.A. | Cortex-M4 Microcontroller | Needed to control the transducers of the stethoscope | https://www.pjrc.com/store/teensy32.html | $19.80 | 1.00 | $19.80
Teensy Audio Board | N.A. | SGTL5000 Audio Board | Needed to process acoustic signals | https://www.pjrc.com/store/teensy3_audio.html | $14.25 | 1.00 | $14.25
Omnidirectional Electret Microphone | 433-1088-ND | Microphone | Needed to capture physiological sounds | http://www.digikey.com/product-detail/en/soberton-inc/EM-6022P/433-1088-ND/3973680 | $1.50 | 1.00 | $1.50
BlueSMiRF | WRL-12577 | Bluetooth Antenna | Needed to connect to a control system wirelessly | https://www.sparkfun.com/products/12577 | $24.95 | 1.00 | $24.95
Micro-LiPo Adapter | ADA-1904 | Charger | Needed to charge a LiPo battery and power the rest of the components | https://www.adafruit.com/products/1904 | $6.95 | 1.00 | $6.95
LiPo Battery | PRT-13851 | LiPo Battery | Needed to power components wirelessly | https://www.sparkfun.com/products/13851 | $4.95 | 1.00 | $4.95
Header Pins | N.A. | Header Pins | Needed to solder boards and breakout boards together | https://www.amazon.com/Uxcell-a14081900ux0592-Single-Header-Connector/dp/B015VY056I | $8.40 | 1.00 | $8.40
micro-USB to USB cable | N.A. | USB Cable | Needed to connect the microcontroller to the computer | https://www.amazon.com/AmazonBasics-Micro-USB-USB-2-0-Cable/dp/B013PVKXTS?s=industrial | $6.99 | 1.00 | $6.99
Stethoscope Custom PCB | N.A. | PCB | Needed to connect boards, microcontrollers, and other components | N.A. | $40.00 | 1.00 | $40.00
 |  |  |  |  |  |  | $0.00
 |  |  |  |  |  |  | $0.00
 |  |  |  |  |  | Total | $127.79
