dash-orlando/AugmentedStethoscope/Hardware/STET002/PCB/Fritzing/pcb_top.dxf

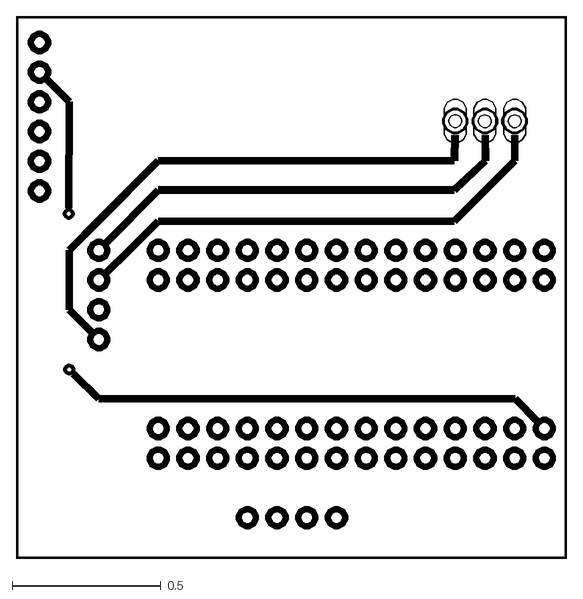
[picture p35: CAD file, 2017-03-07]
Hardware/STET002/PCB/Fritzing/pcb_top.dxf
1.85 x 1.83
