dash-orlando/AugmentedStethoscope/Documentation/Analysis Software/Python-based Analysis Algorithms Guide.docx

# Requirements

## Hardware Requirements

- PC running Windows
- Raspberry Pi

## Software Requirements

1. Install Python 2.7 (https://www.python.org/downloads/)
2. Install the following Python packages:
  2.1. Numpy with mkl (Numpy-1.11.3+mkl)
    2.1.1. Download the unofficial binaries (http://www.lfd.uci.edu/~gohlke/pythonlibs/)
    2.1.2. Open the command prompt
    2.1.3. Download wheel by;

>>> python –m pip install --upgrade pip

>>> python –m pip install –U wheel

    2.1.4. Install the wheel file

>>> python –m pip install ____.whl

Note: Installing these binaries may trigger the uninstallation of more recent versions of numpy. As of 07/06/2017, this command will trigger version numpy-1.12.0 to be uninstalled. The process takes place automatically.

  2.2. SciPy (Scipy-0.19.1)
    2.2.1. Same steps shown in 2.1.1-4

# References

Augmented Stethoscope 06/28/2017 Python-based Analysis Algorithms Fluvio L Lobo Fenoglietto
