dash-orlando/AugmentedStethoscope/Hardware/STET004/Estimates/STET004 PCB Fabrication and Assembly Quote.PNG

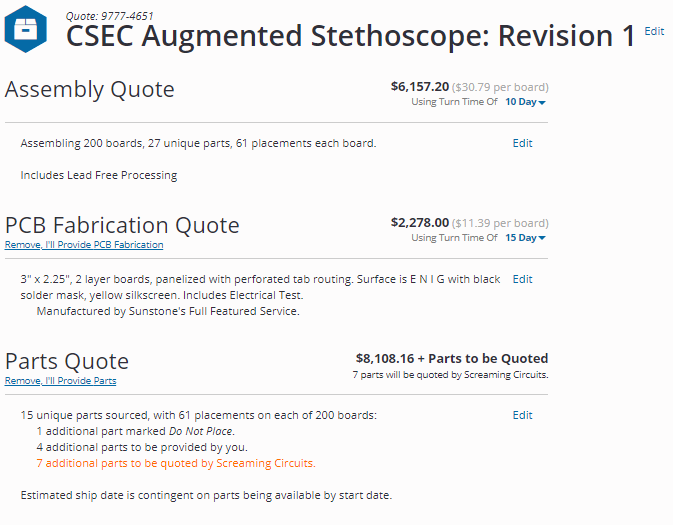
Hardware/STET004/Estimates/STET004 PCB Fabrication and Assembly Quote.PNG
