dash-orlando/AugmentedStethoscope/Hardware/STET002/PCB/Fritzing/STET002_pcb.pdf

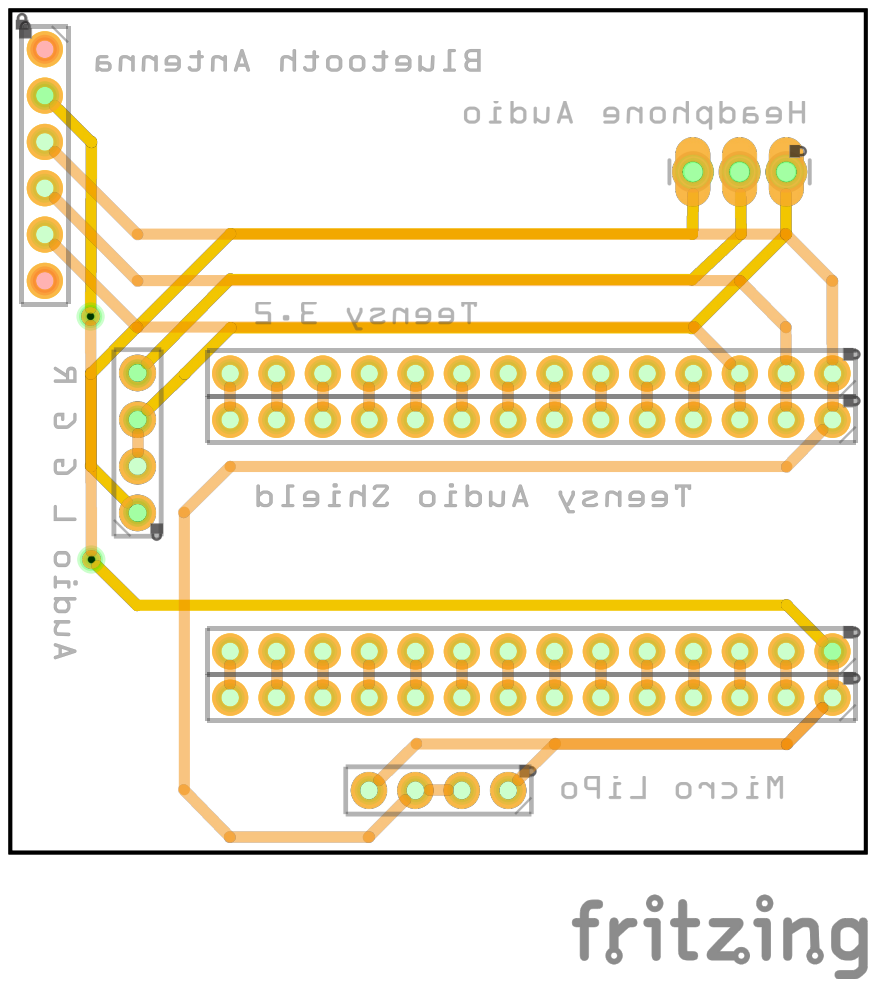
[picture p48: page 1]
