dash-orlando/AugmentedStethoscope/Hardware/STET002/PCB/Fritzing/Etchable/STET002_etch_copper_bottom.pdf

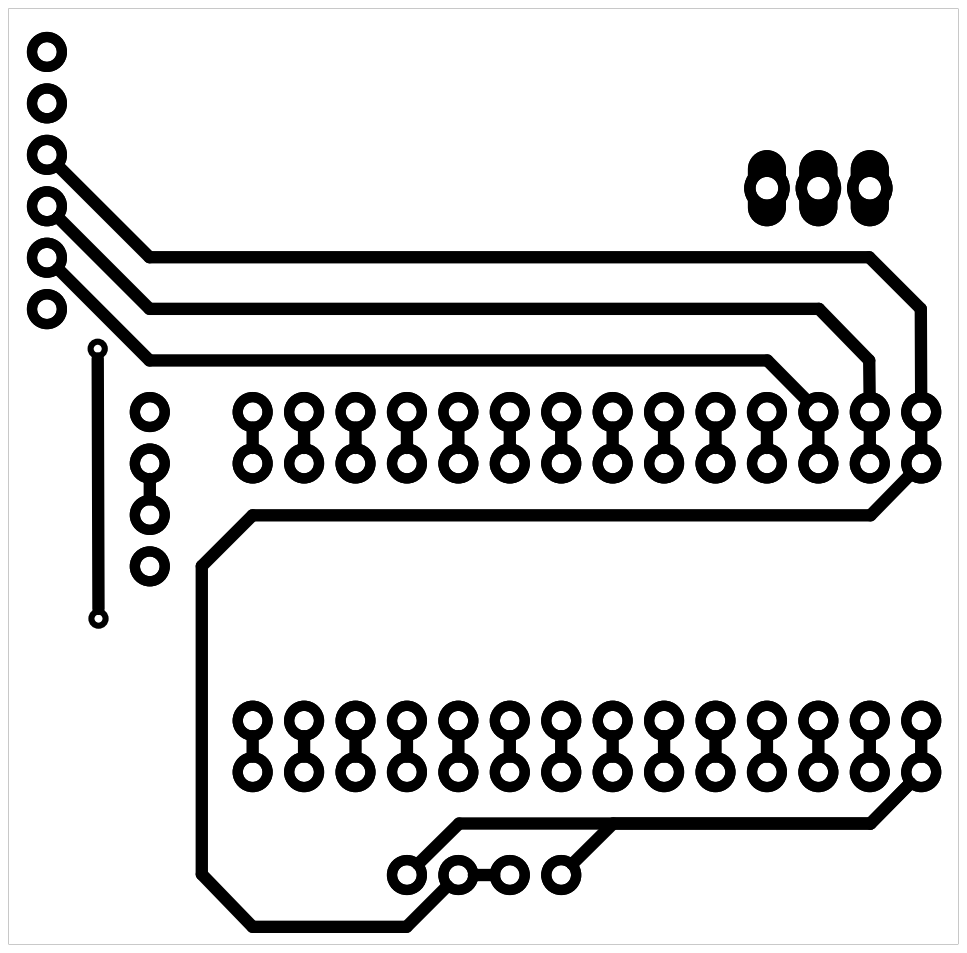
[picture p49: page 1]
