dash-orlando/AugmentedStethoscope/Hardware/STET002/PCB/Fritzing/Etchable/STET002_etch_copper_bottom_mirror.pdf

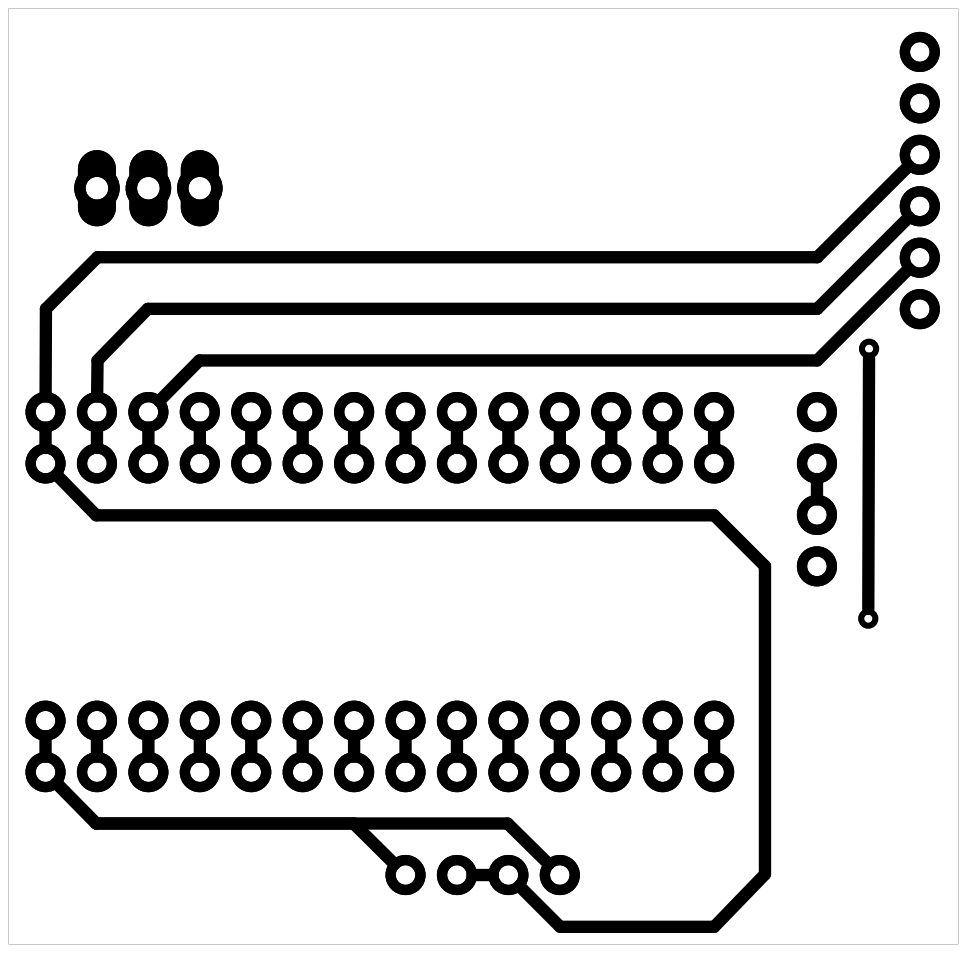
[picture p50: page 1]
