dash-orlando/AugmentedStethoscope/Hardware/STET002/PCB/Fritzing/Etchable/STET002_etch_copper_top.pdf

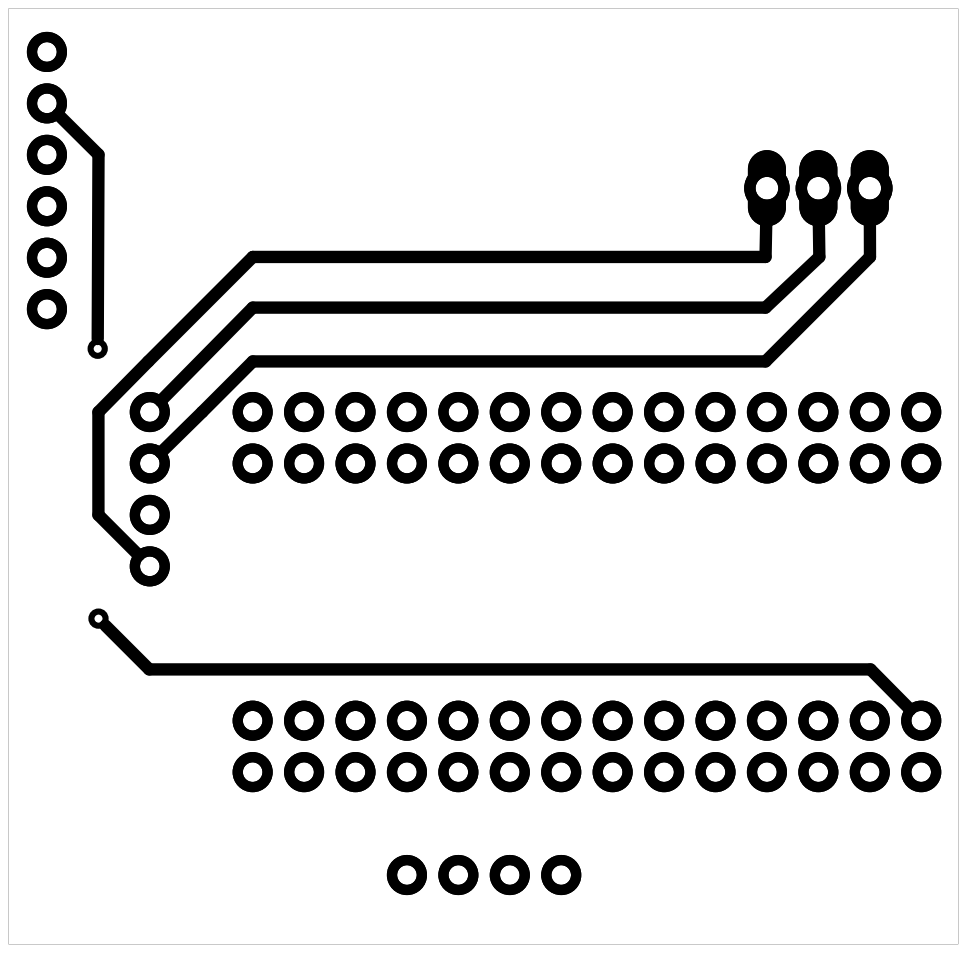
[picture p51: page 1]
