dash-orlando/AugmentedStethoscope/Hardware/STET002/PCB/Fritzing/Etchable/STET002_etch_copper_top_mirror.pdf

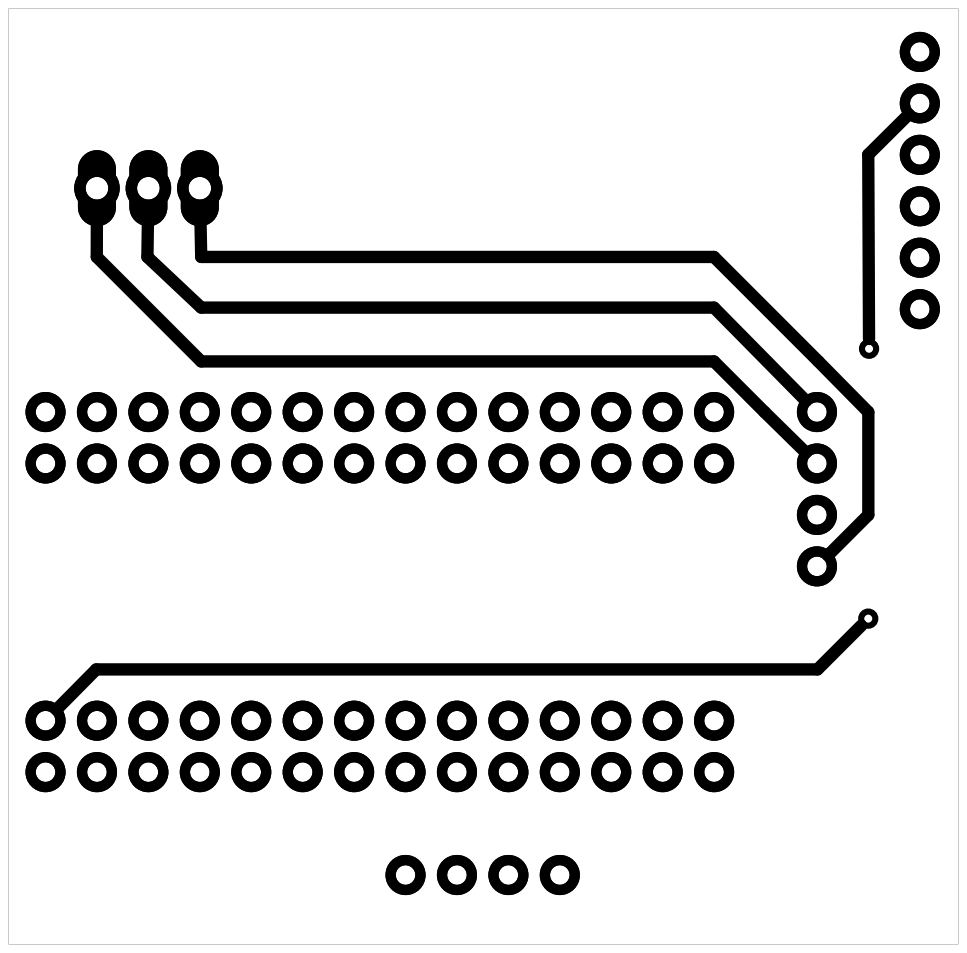
[picture p52: page 1]
