dash-orlando/AugmentedStethoscope/Hardware/STET002/PCB/Fritzing/Etchable/STET002_etch_mask_bottom.pdf

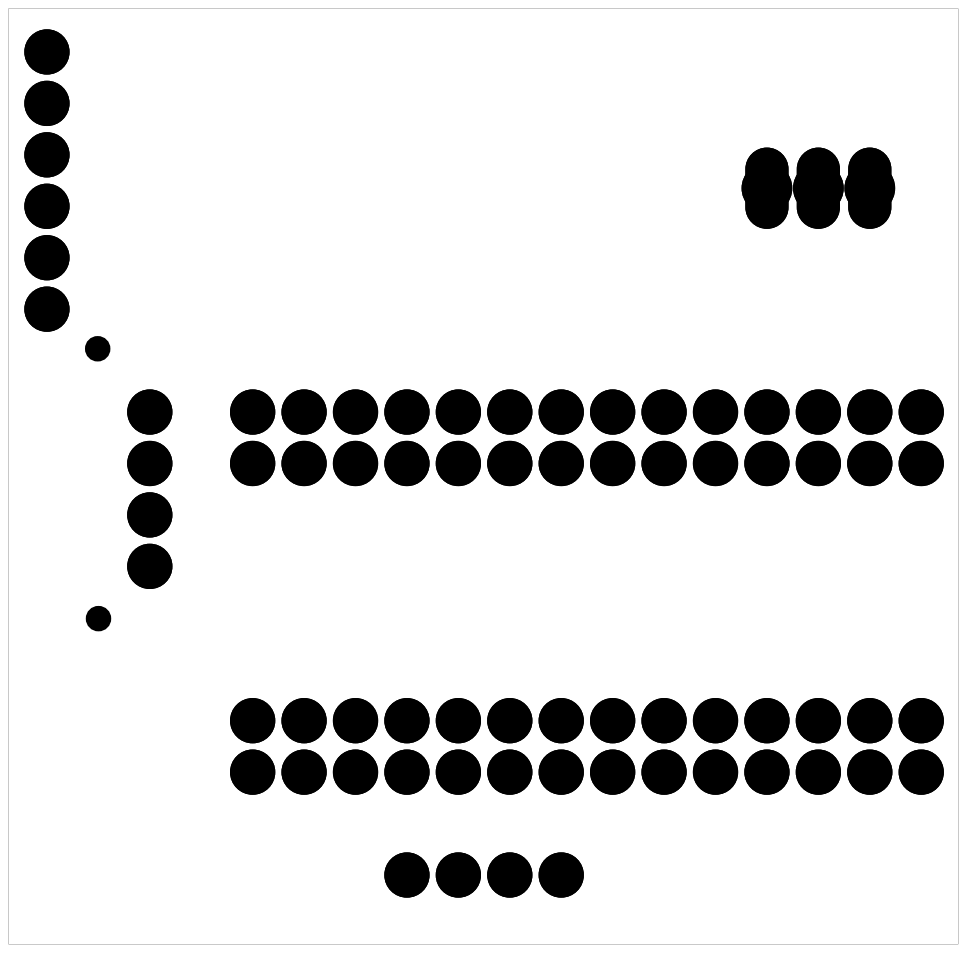
[picture p53: page 1]
