dash-orlando/AugmentedStethoscope/Hardware/STET002/PCB/Fritzing/Etchable/STET002_etch_mask_bottom_mirror.pdf

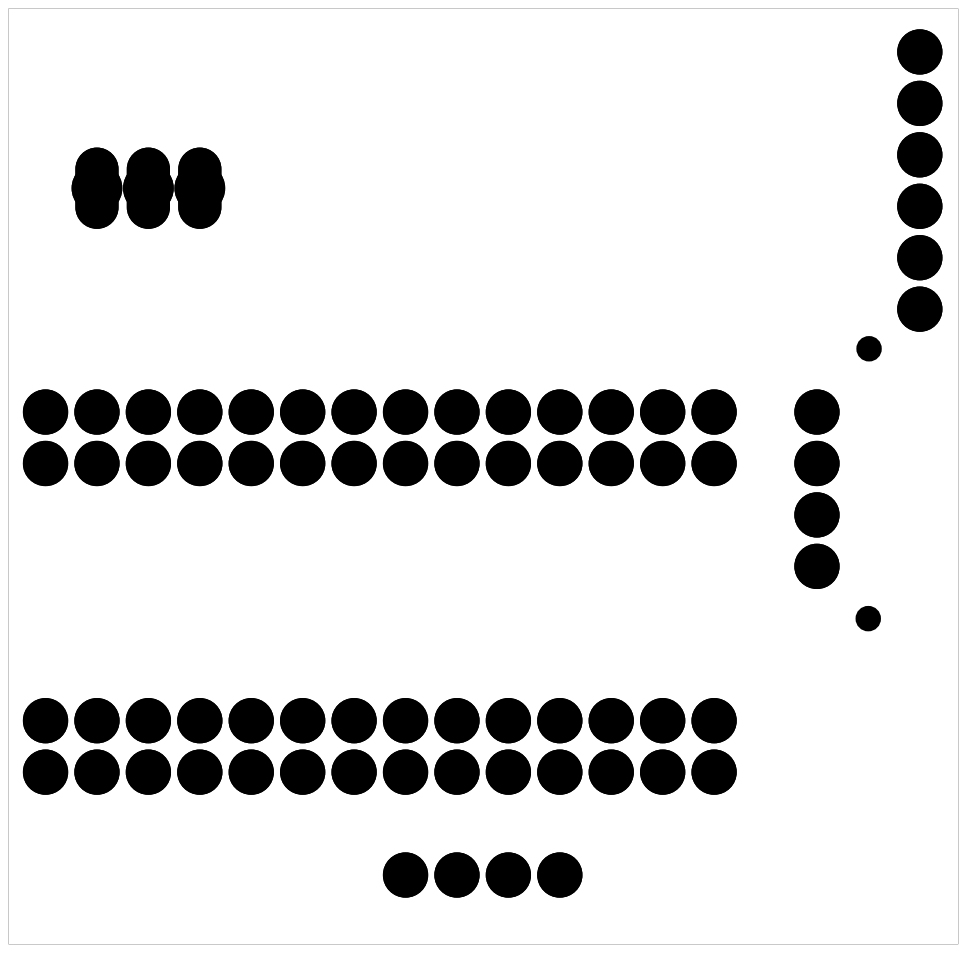
[picture p54: page 1]
