dash-orlando/AugmentedStethoscope/Hardware/STET002/PCB/Fritzing/Etchable/STET002_etch_silk_bottom.pdf

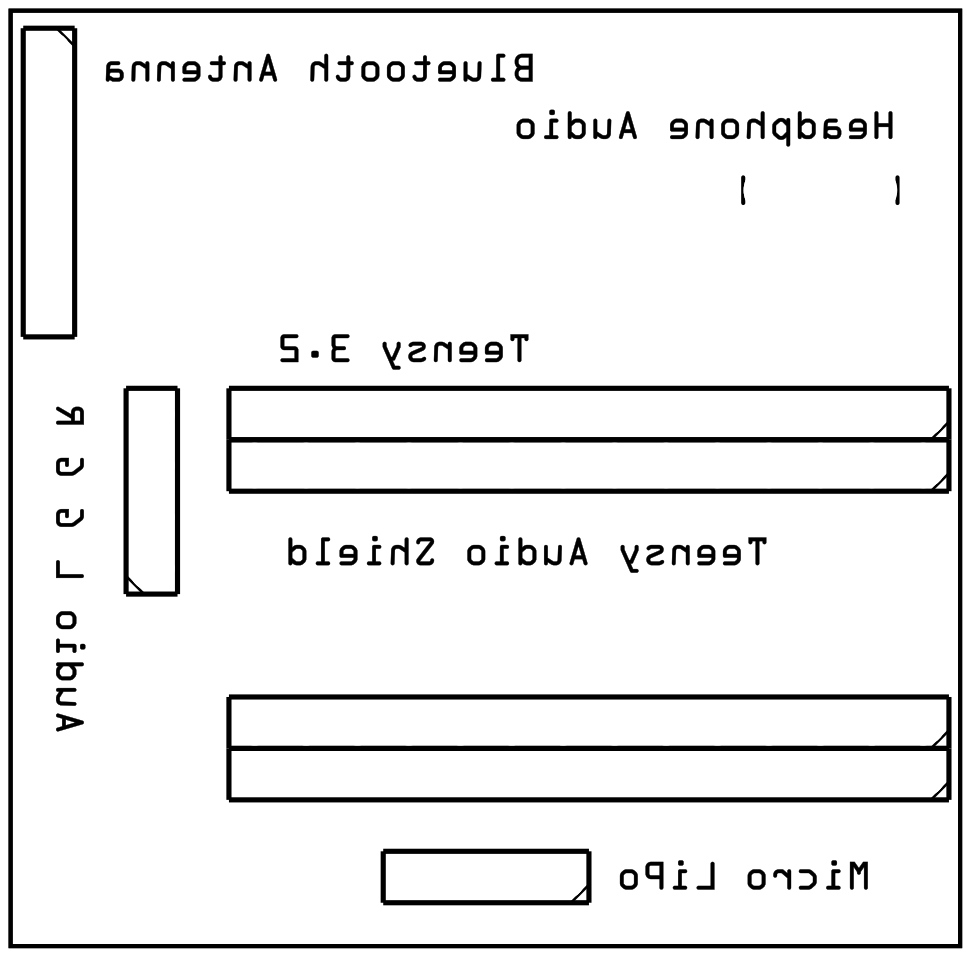
[picture p55: page 1]
