dash-orlando/AugmentedStethoscope/Hardware/STET002/PCB/Fritzing/Etchable/STET002_etch_silk_bottom_mirror.pdf

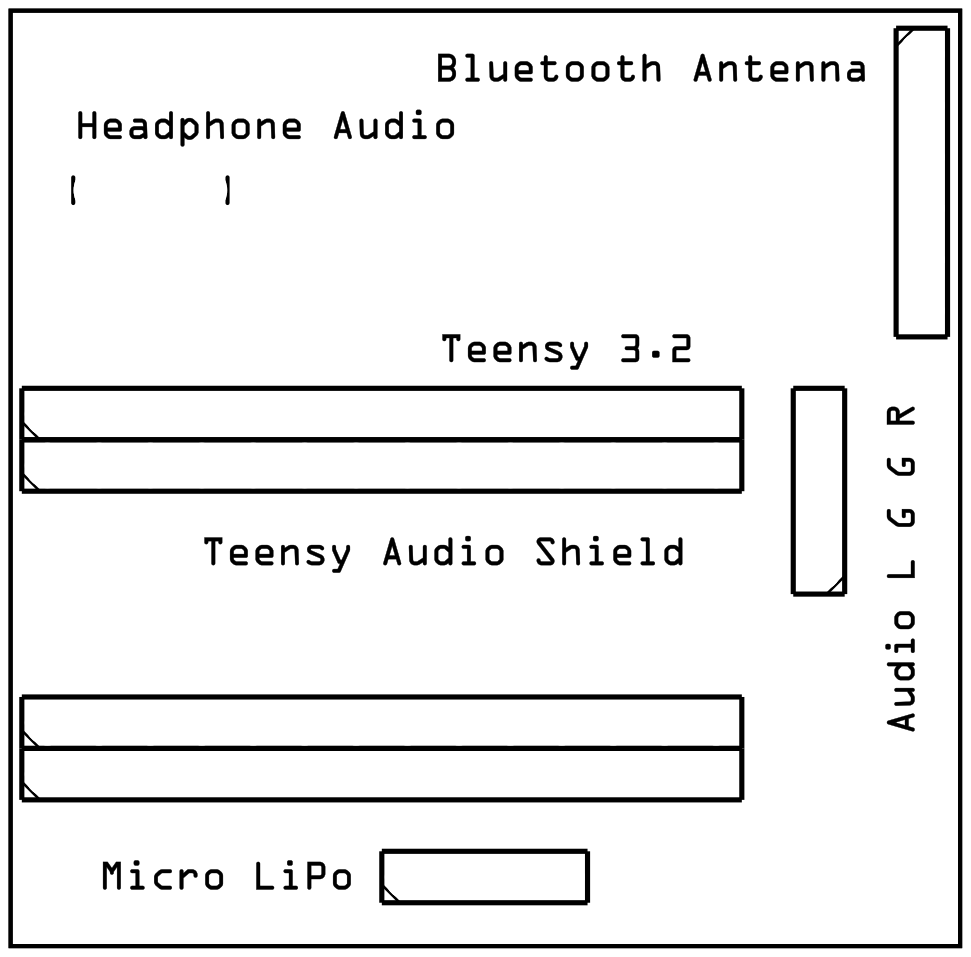
[picture p56: page 1]
