dash-orlando/AugmentedStethoscope/Hardware/STET002/PCB/Fritzing/Etchable/STET002_etch_silk_top_mirror.pdf

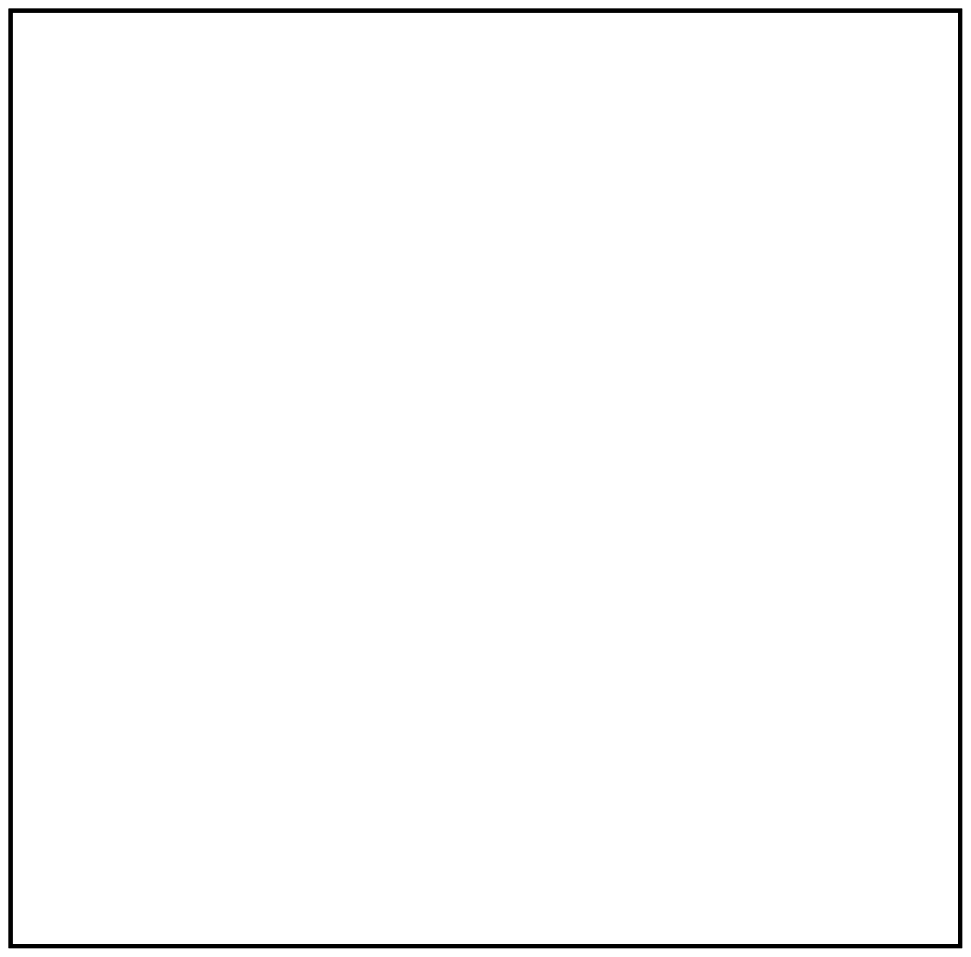
[picture p58: page 1]
