dash-orlando/AugmentedStethoscope/Hardware/STET002/PCB/PDF/STET002_etch_copper_bottom.pdf

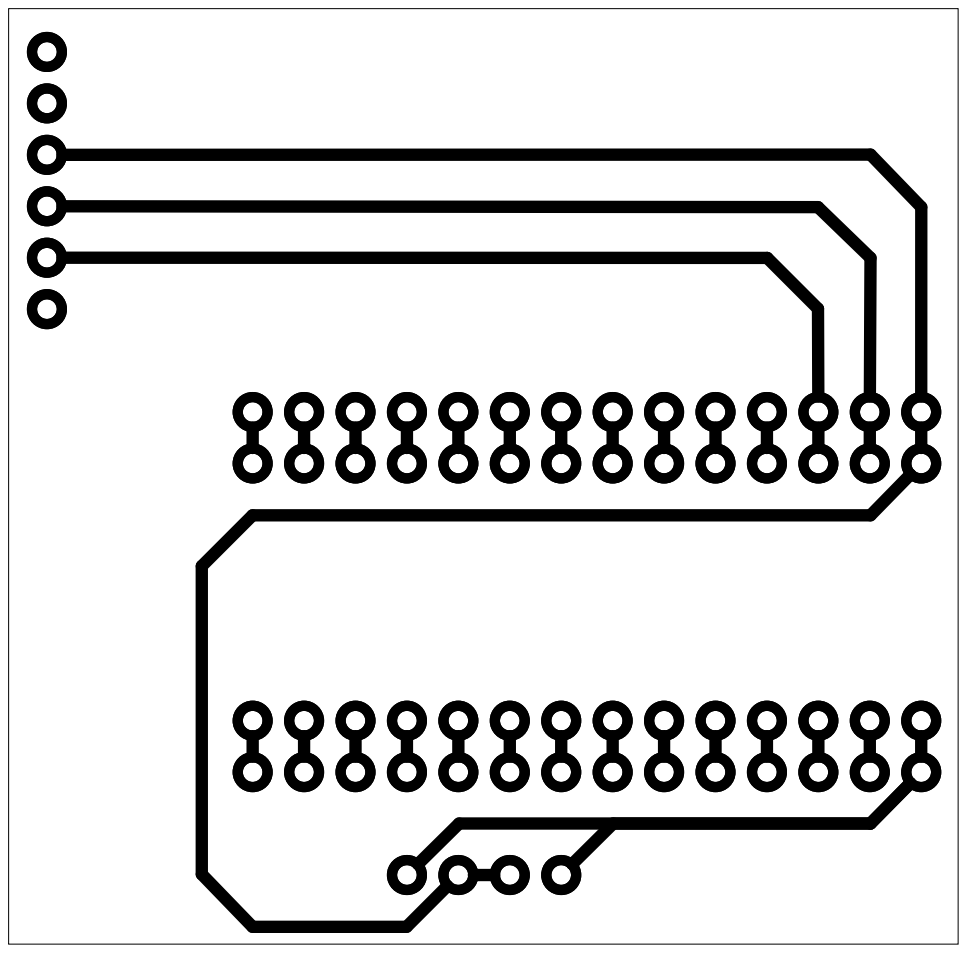
[picture p59: page 1]
