dash-orlando/AugmentedStethoscope/Hardware/STET002/PCB/PDF/STET002_etch_copper_bottom_mirror.pdf

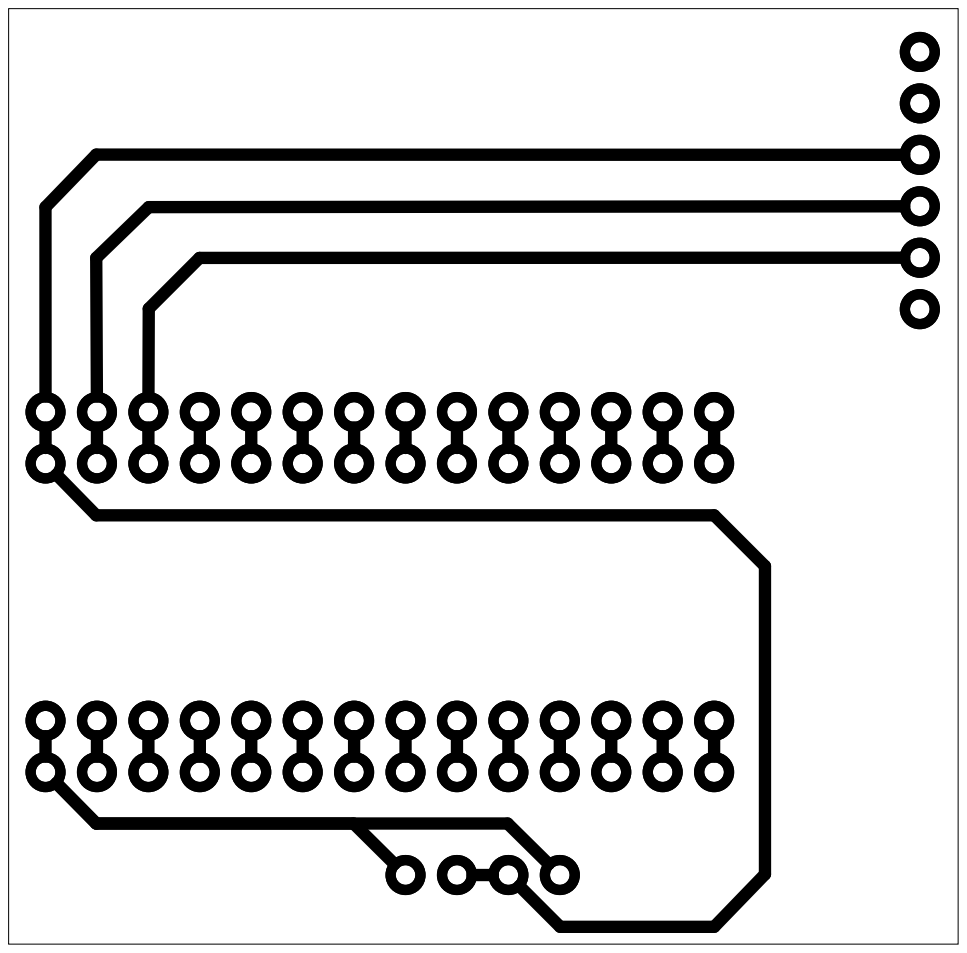
[picture p60: page 1]
