dash-orlando/AugmentedStethoscope/Hardware/STET002/PCB/PDF/STET002_etch_copper_top.pdf

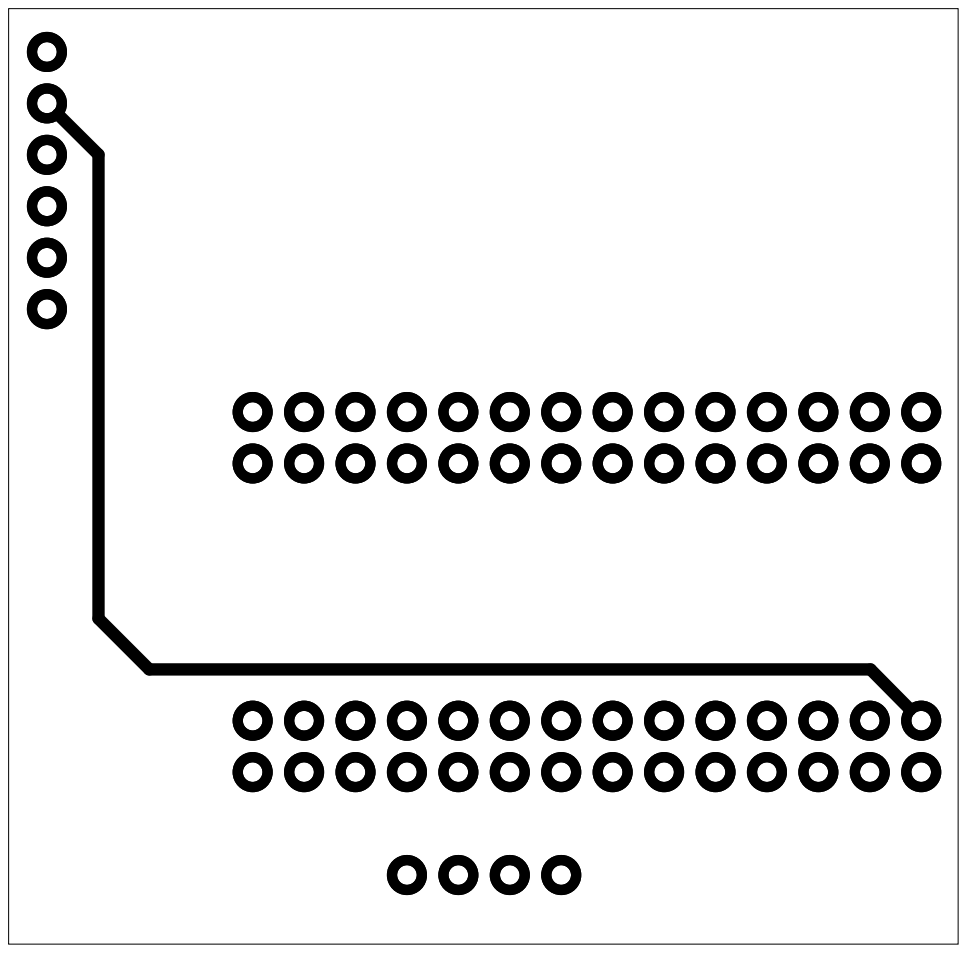
[picture p61: page 1]
