dash-orlando/AugmentedStethoscope/Hardware/STET002/PCB/PDF/STET002_etch_copper_top_mirror.pdf

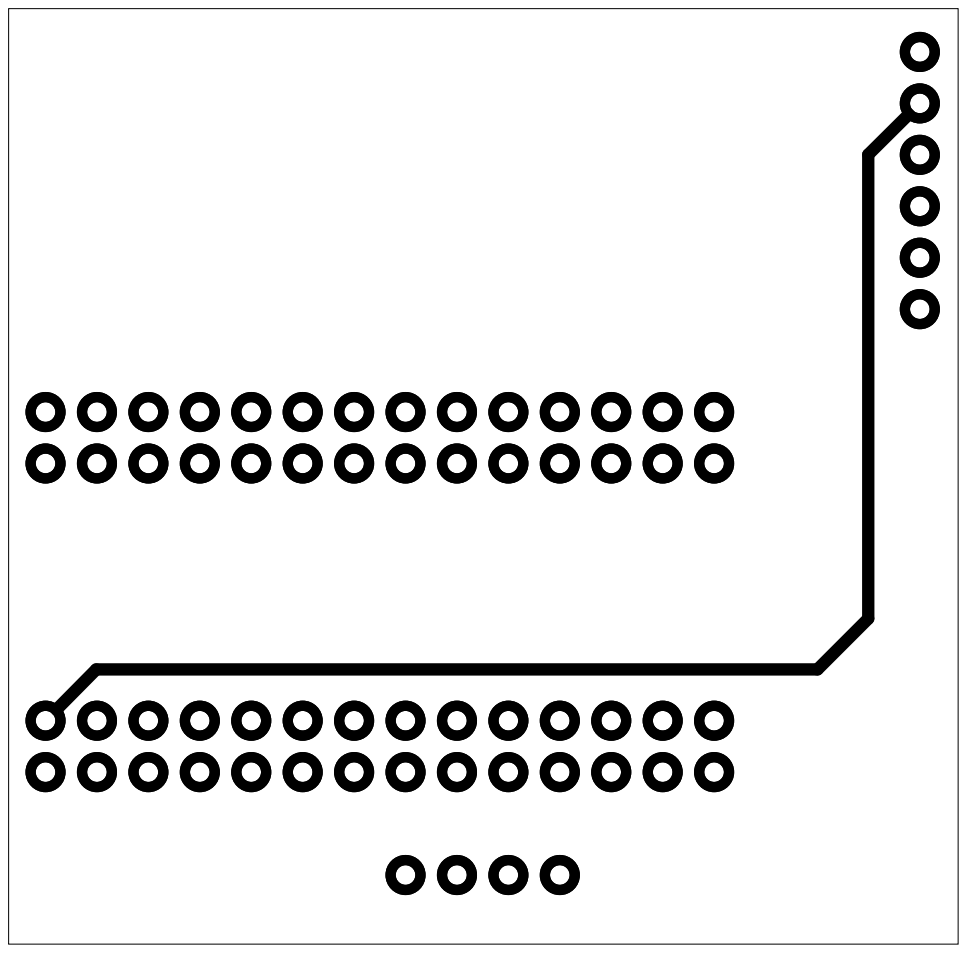
[picture p62: page 1]
