dash-orlando/AugmentedStethoscope/Hardware/STET002/PCB/PDF/STET002_etch_mask_bottom.pdf

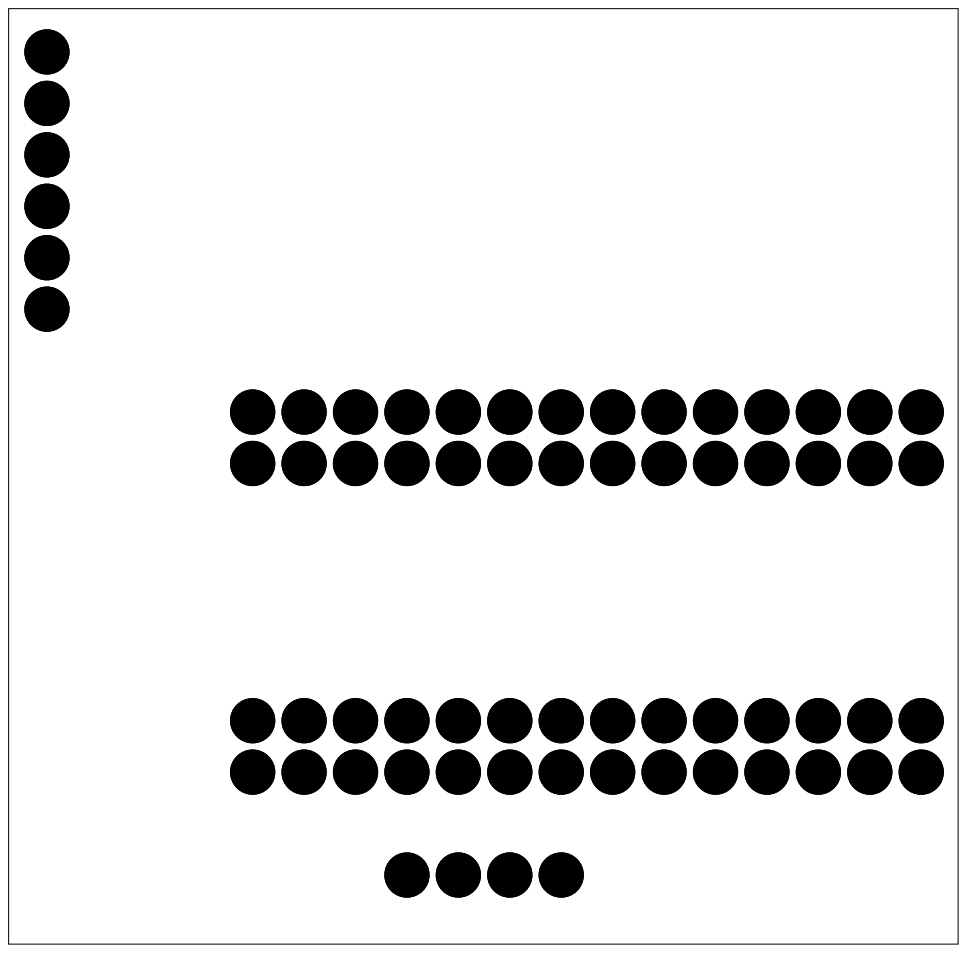
[picture p63: page 1]
