dash-orlando/AugmentedStethoscope/Hardware/STET002/PCB/PDF/STET002_etch_mask_bottom_mirror.pdf

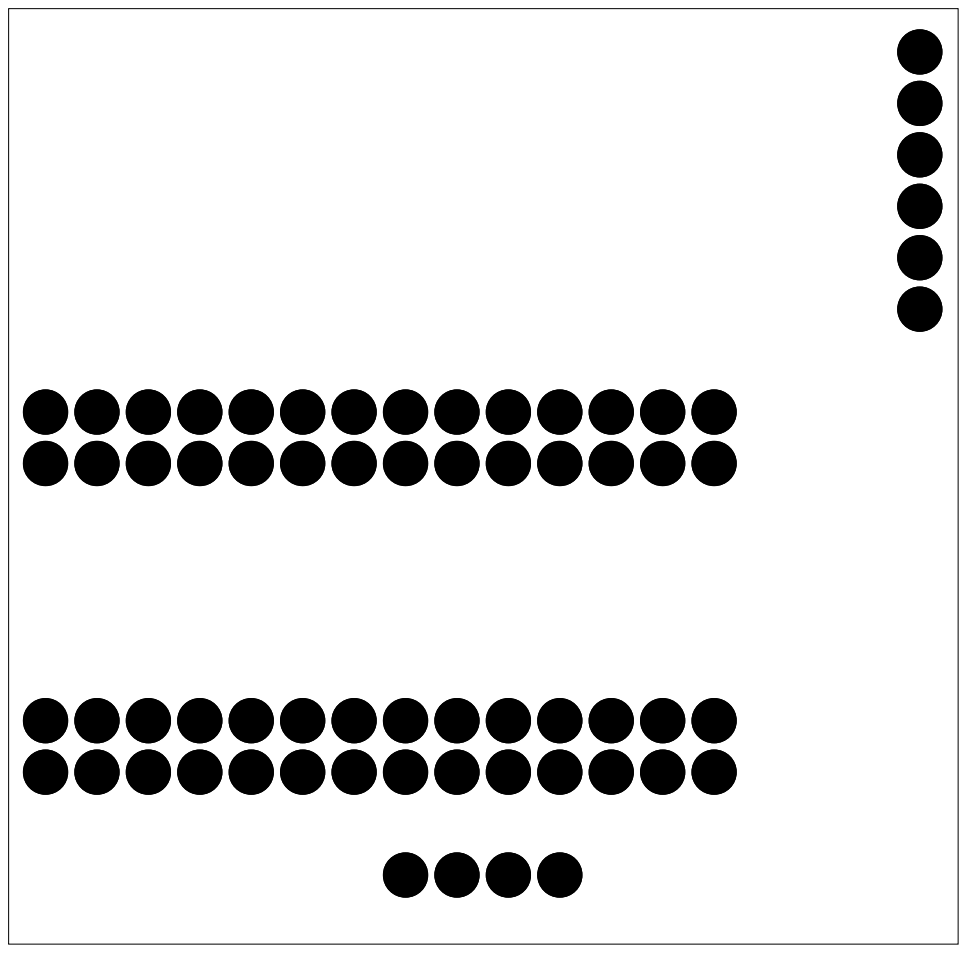
[picture p64: page 1]
