dash-orlando/AugmentedStethoscope/Hardware/STET002/PCB/PDF/STET002_etch_silk_bottom.pdf

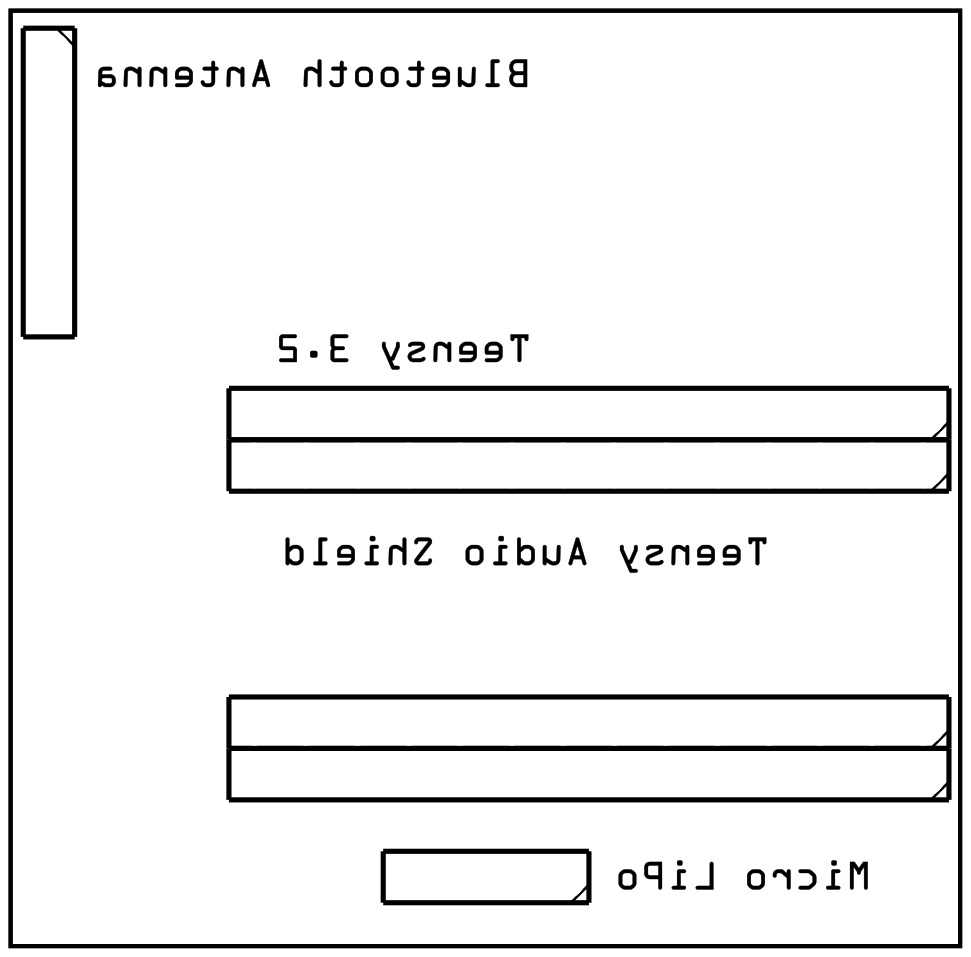
[picture p65: page 1]
