dash-orlando/AugmentedStethoscope/Hardware/STET002/PCB/PDF/STET002_etch_silk_bottom_mirror.pdf

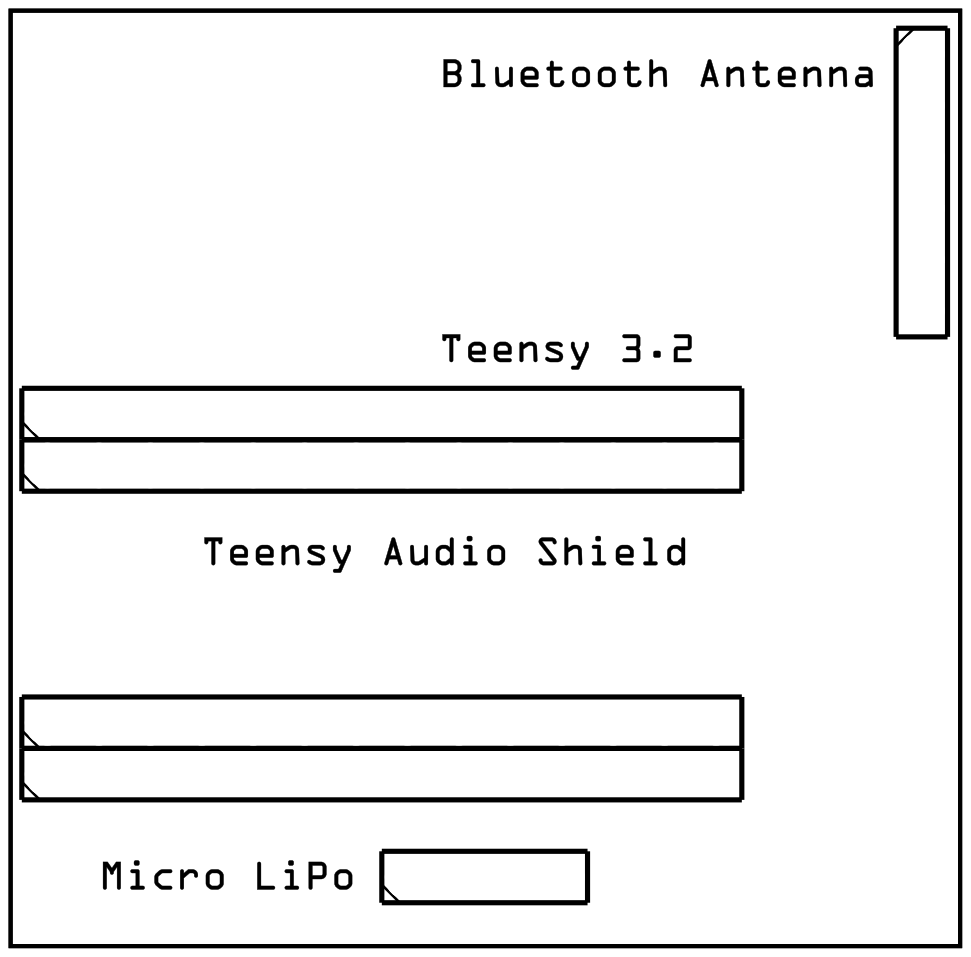
[picture p66: page 1]
