dash-orlando/AugmentedStethoscope/(list of files, drawings)

Other design files:
Hardware/STET002/PCB/Fritzing/STET002.fzz
