dash-orlando/AugmentedStethoscope/Hardware/STET004/Eagle/AugmentedStethoscope_v7.brd

## EAGLE design Hardware/STET004/Eagle/AugmentedStethoscope_v7.brd (2019-04-03)

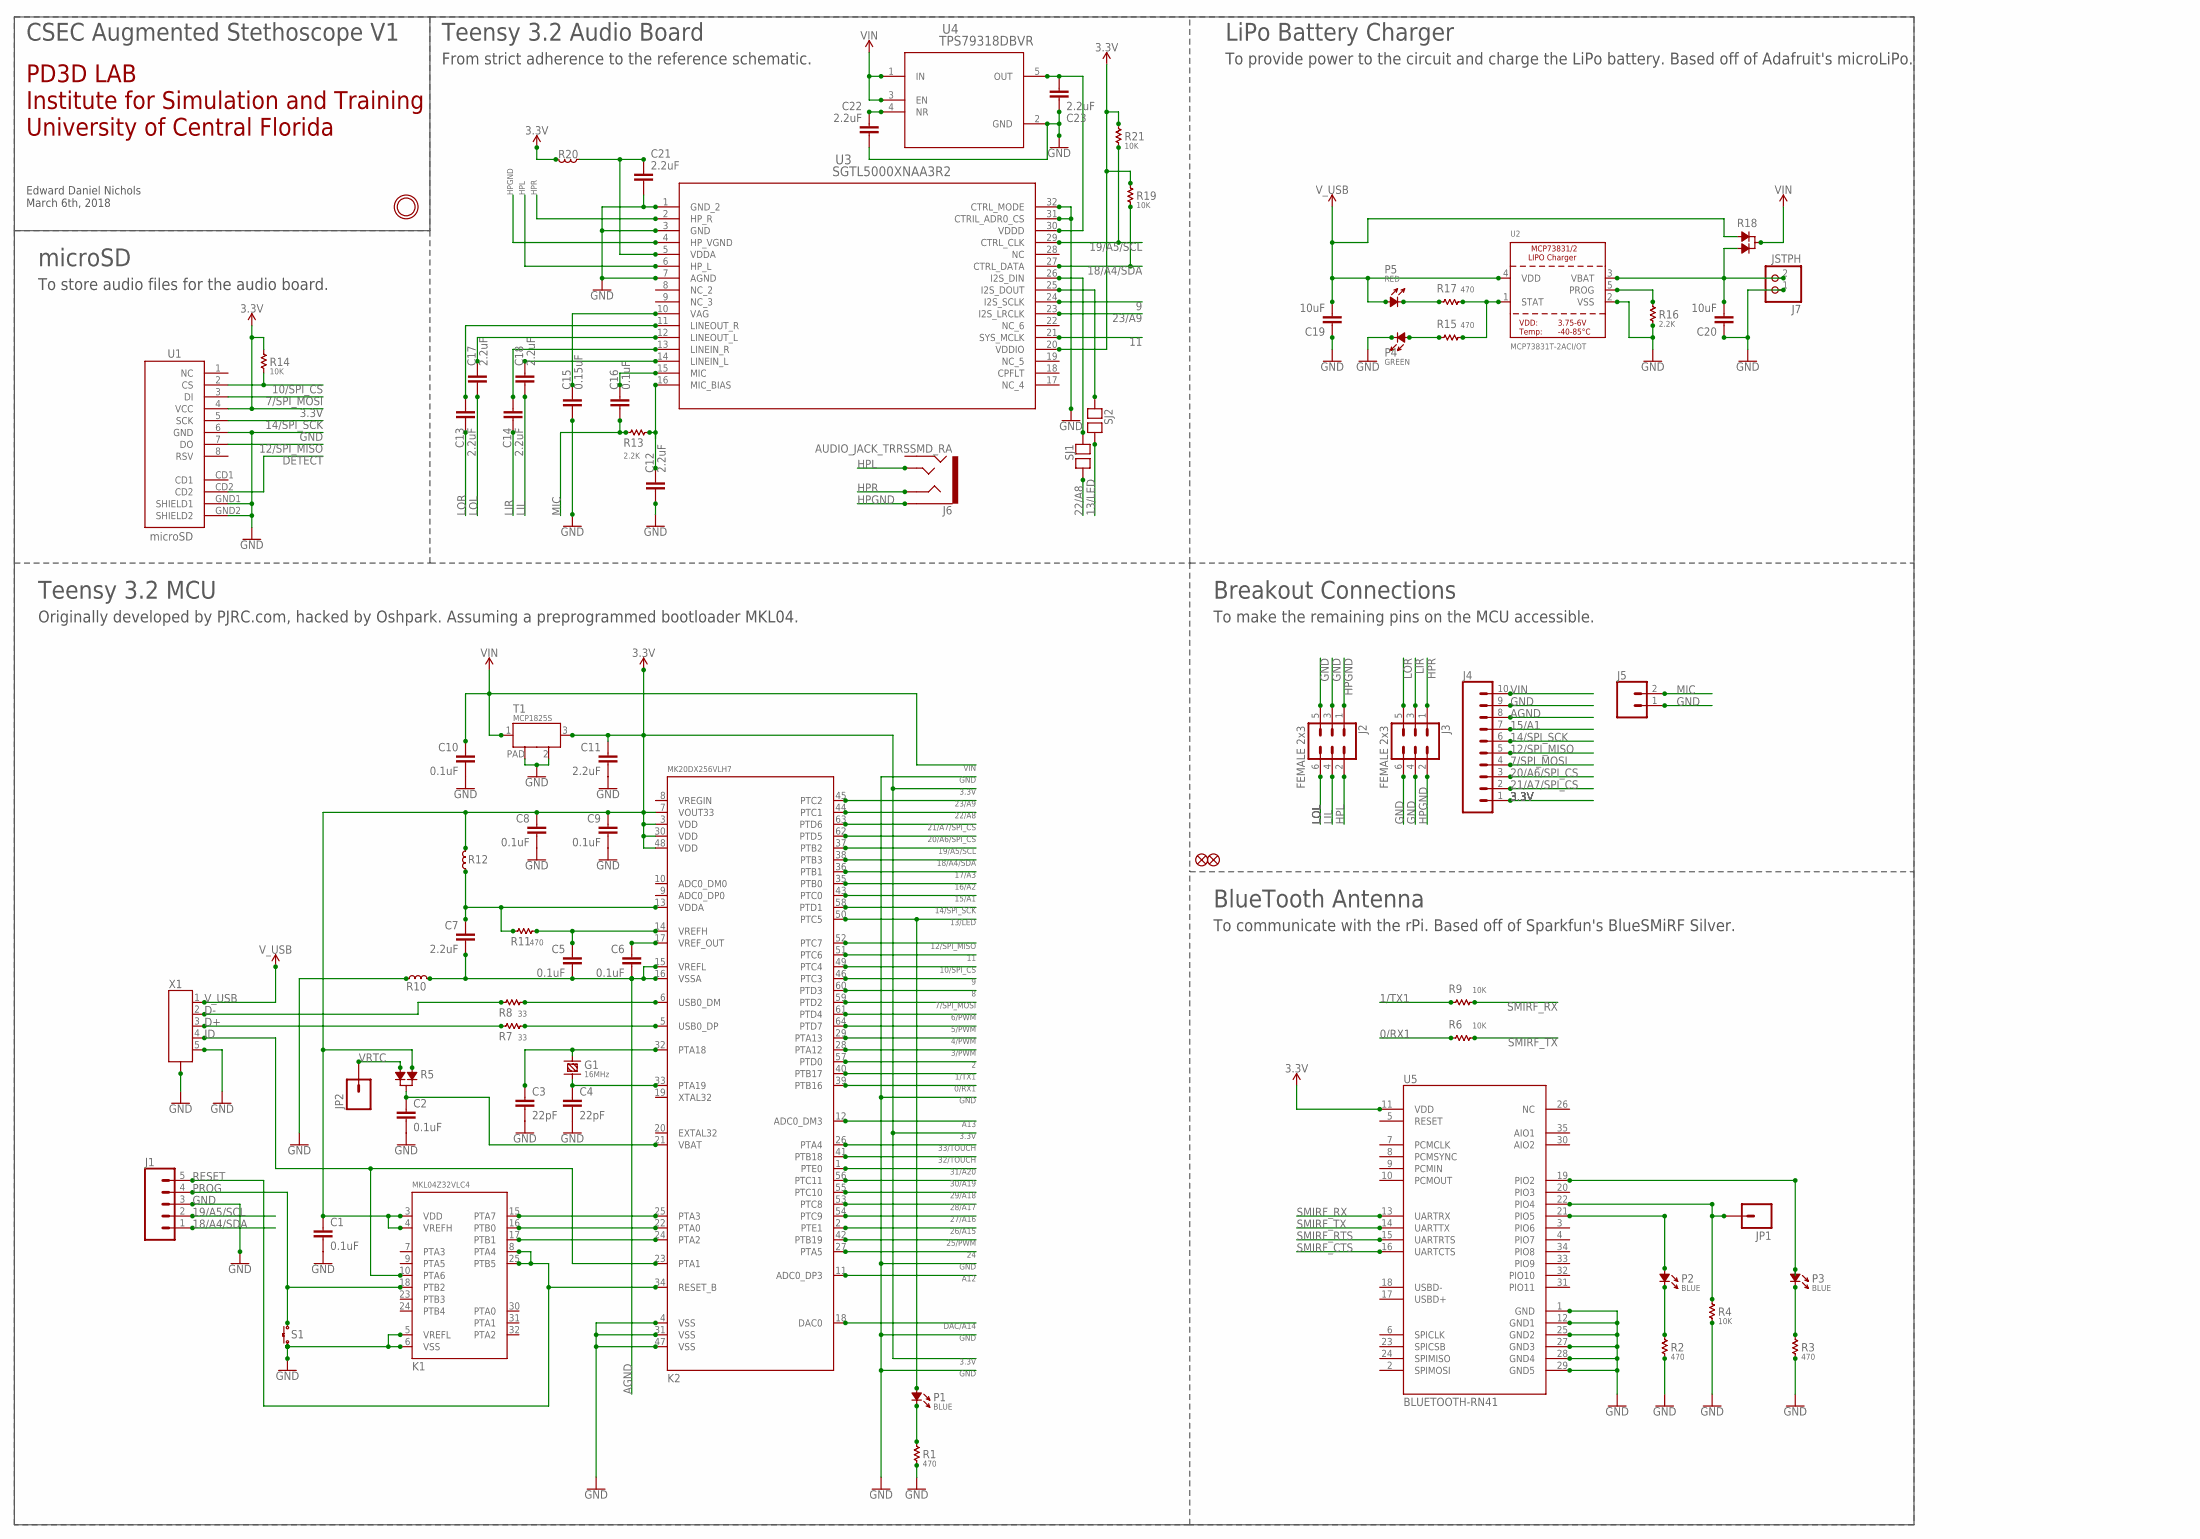
[picture p67: schematic AugmentedStethoscope_v7.sch]

Parts:
C1, C2, C5, C6, C8, C9, C10, C16: 0.1uF; 0603
C3, C4: 22pF; 0603
C7, C11, C12, C13, C14, C17, C18, C21, C22, C23: 2.2uF; 0603
C15: 0.15uF; 0603
C19, C20: 10uF; 0805
FID1, FID2: FIDUCIAL""; FIDUCIAL_1MM
G1: 16MHz; HC49US
J1: CONN_05; 1X05
J2, J3: FEMALE 2x3; 2X3
J4: CONN_10"; 1X10
J5: CONN_02; 1X02
J6: AUDIO_JACK_TRRSSMD_RA; AUDIO_JACK_3.5MM_TRRS_SMD_RA
J7: JSTPH; JSTPH2
JP1, JP2: M01SMDNS; 1X01NS
K1: MKL04Z32VLC4; LQFP32-08
K2: MK20DX256VLH7; LQFP64-05
P1, P2, P3: BLUE; LED-0805
P4: GREEN; LED-0805
P5: RED; LED-0805
R1, R2, R3, R11, R15, R17: 470; R0603
R4, R6, R9, R14, R19, R21: 10K; R0603
R5, R18: DIODE_DUAL; SOT-23
R7, R8: 33; R0603
R10, R12, R20: FERRITE; L0603
R13, R16: 2.2K; R0603
S1: TACT_SWITCH; ALPS_SKHH
SJ1, SJ2: SOLDERJUMPER
T1: MCP1825S; SOT-223
U1: microSD; MICRO-SD-SOCKET-PP
U2: MCP73831T-2ACI/OT; SOT23-5
U3: SGTL5000XNAA3R2; QFN32
U4: TPS79318DBVR; DBV5
U5: BLUETOOTH-RN41; RN41
U$1: MOUNTINGHOLE2.5; MOUNTINGHOLE_2.5_PLATED
X1: MINI-USB; MOLEX_SD-67503-010

Connections:
0/RX1: K2.39 (PTB16), R6.1
1/TX1: K2.40 (PTB17), R9.1
2: K2.57 (PTD0)
3.3V: C1.1, C8.1, C9.1, C11.1, J4.1, K1.3 (VDD), K1.4 (VREFH), K2.3 (VDD), K2.7 (VOUT33), K2.30 (VDD), K2.48 (VDD), R5.1, R12.2, R14.2, R19.2, R20.2, R21.2, T1.3 (OUT), U1.4 (VCC), U3.20 (VDDIO), U5.11 (VDD)
3/PWM: K2.28 (PTA12)
4/PWM: K2.29 (PTA13)
5/PWM: K2.64 (PTD7)
6/PWM: K2.61 (PTD4)
7/SPI_MOSI: J4.4, K2.59 (PTD2), U1.3 (DI)
8: K2.60 (PTD3)
9: K2.46 (PTC3), U3.24 (I2S_SCLK)
10/SPI_CS: K2.49 (PTC4), R14.1, U1.2 (CS)
11: K2.51 (PTC6), U3.21 (SYS_MCLK)
12/SPI_MISO: J4.5, K2.52 (PTC7), U1.7 (DO)
13/LED: K2.50 (PTC5), P1.+, SJ2.2
14/SPI_SCK: J4.6, K2.58 (PTD1), U1.5 (SCK)
15/A1: J4.7, K2.43 (PTC0)
16/A2: K2.35 (PTB0)
17/A3: K2.36 (PTB1)
18/A4/SDA: J1.1, K2.38 (PTB3), R19.1, U3.27 (CTRL_DATA)
19/A5/SCL: J1.2, K2.37 (PTB2), R21.1, U3.29 (CTRL_CLK)
20/A6/SPI_CS: J4.3, K2.62 (PTD5)
21/A7/SPI_CS: J4.2, K2.63 (PTD6)
22/A8: K2.44 (PTC1), SJ1.2
23/A9: K2.45 (PTC2), U3.23 (I2S_LRCLK)
24: K2.27 (PTA5)
25/PWM: K2.42 (PTB19)
26/A15: K2.2 (PTE1)
27/A16: K2.54 (PTC9)
28/A17: K2.53 (PTC8)
29/A18: K2.55 (PTC10)
30/A19: K2.56 (PTC11)
31/A20: K2.1 (PTE0)
32/TOUCH: K2.41 (PTB18)
33/TOUCH: K2.26 (PTA4)
A12: K2.11 (ADC0_DP3)
A13: K2.12 (ADC0_DM3)
AGND: C5.2, C6.2, C7.2, J4.8, K2.15 (VREFL), K2.16 (VSSA), R10.2
D3: P2.-, R2.2
D4: P3.-, R3.2
D+: R7.1, X1.3
D-: R8.1, X1.2
DAC/A14: K2.18 (DAC0)
DETECT: U1.CD2
GND: C1.2, C2.2, C3.2, C4.2, C8.2, C9.2, C10.2, C11.2, C12.2, C15.1, C19.1, C20.1, C21.2, C22.2, C23.1, J1.3, J2.3, J2.5, J3.4, J3.6, J4.9, J5.1, J7.1, K1.5 (VREFL), K1.6 (VSS), K2.4 (VSS), K2.31 (VSS), K2.47 (VSS), P4.-, R1.1, R2.1, R3.1, R4.1, R10.1, R16.1, S1.3, S1.4 (3), T1.2 (GND), T1.PAD, U1.6 (GND), U1.GND1 (SHIELD1), U1.GND2 (SHIELD2), U2.2 (VSS), U3.1 (GND_2), U3.3 (GND), U3.7 (AGND), U3.31 (CTRIL_ADR0_CS), U3.32 (CTRL_MODE), U4.2 (GND), U5.1 (GND), U5.12 (GND1), U5.25 (GND2), U5.27 (GND3), U5.28 (GND4), U5.29 (GND5), X1.5, X1.P$1 (CASE), X1.P$2 (CASE), X1.P$3 (CASE), X1.P$4 (CASE), X1.P$5 (CASE), X1.P$6 (CASE)
HPGND: J2.1, J3.2, J6.EARTH, U3.4 (HP_VGND)
HPL: J2.2, J6.TIP, U3.6 (HP_L)
HPR: J3.1, J6.RING1, U3.2 (HP_R)
ID: K1.10 (PTA6), K2.23 (PTA1), X1.4
LIL: C18.2, J2.4
LIL_ISO: C18.1, U3.14 (LINEIN_L)
LIR: C14.2, J3.3
LIR_ISO: C14.1, U3.13 (LINEIN_R)
LOL: C17.2, J2.6
LOL_ISO: C17.1, U3.12 (LINEOUT_L)
LOR: C13.2, J3.5
LOR_ISO: C13.1, U3.11 (LINEOUT_R)
MIC: C16.1, J5.2, R13.1
MIC_BIAS: C12.1, R13.2, U3.16 (MIC_BIAS)
unnamed: C20.2, J7.2, R18.2, U2.3 (VBAT)
unnamed: K1.16 (PTB0), K2.22 (PTA0)
unnamed: K1.17 (PTB1), K2.24 (PTA2)
unnamed: C15.2, U3.10 (VAG)
unnamed: C3.1, G1.1, K2.32 (PTA18)
unnamed: C4.1, G1.2, K2.33 (PTA19)
unnamed: C5.1, K2.14 (VREFH), R11.2
unnamed: C22.1, U4.4 (NR)
unnamed: SJ1.1, U3.26 (I2S_DIN)
unnamed: K2.5 (USB0_DP), R7.2
unnamed: C6.1, K2.17 (VREF_OUT)
unnamed: C23.2, U3.30 (VDDD), U4.5 (OUT)
unnamed: SJ2.1, U3.25 (I2S_DOUT)
unnamed: K2.6 (USB0_DM), R8.2
unnamed: C16.2, U3.15 (MIC)
unnamed: P3.+, U5.19 (PIO2)
unnamed: C7.1, K2.13 (VDDA), R11.1, R12.1
unnamed: P1.-, R1.2
unnamed: C2.1, K2.21 (VBAT), R5.3
unnamed: K1.15 (PTA7), K2.25 (PTA3)
unnamed: P5.-, R17.1
unnamed: R15.2, R17.2, U2.1 (STAT)
unnamed: P2.+, U5.21 (PIO5)
unnamed: R16.2, U2.5 (PROG)
unnamed: P4.+, R15.1
unnamed: C21.1, R20.1, U3.5 (VDDA)
PIO4: JP1.1, R4.2, U5.22 (PIO4)
PROG: J1.4, K1.18 (PTB2), S1.1, S1.2 (1)
RESET: J1.5, K1.8 (PTA4), K1.25 (PTB5), K2.34 (RESET_B)
SMIRF_CTS: U5.16 (UARTCTS)
SMIRF_RTS: U5.15 (UARTRTS)
SMIRF_RX: R9.2, U5.13 (UARTRX)
SMIRF_TX: R6.2, U5.14 (UARTTX)
VIN: C10.1, J4.10, R18.3, T1.1 (IN), U4.1 (IN), U4.3 (EN)
VRTC: JP2.1, R5.2
V_USB: C19.2, P5.+, R18.1, U2.4 (VDD), X1.1

Notes on the sheet:
Teensy 3.2 MCU
Originally developed by PJRC.com, hacked by Oshpark. Assuming a preprogrammed bootloader MKL04.
microSD
To store audio files for the audio board.
Breakout Connections
To make the remaining pins on the MCU accessible.
BlueTooth Antenna
To communicate with the rPi. Based off of Sparkfun's BlueSMiRF Silver.
Teensy 3.2 Audio Board
From strict adherence to the reference schematic.
LiPo Battery Charger
To provide power to the circuit and charge the LiPo battery. Based off of Adafruit's microLiPo.
PD3D LAB Institute for Simulation and Training University of Central Florida
CSEC Augmented Stethoscope V1
Edward Daniel Nichols March 6th, 2018

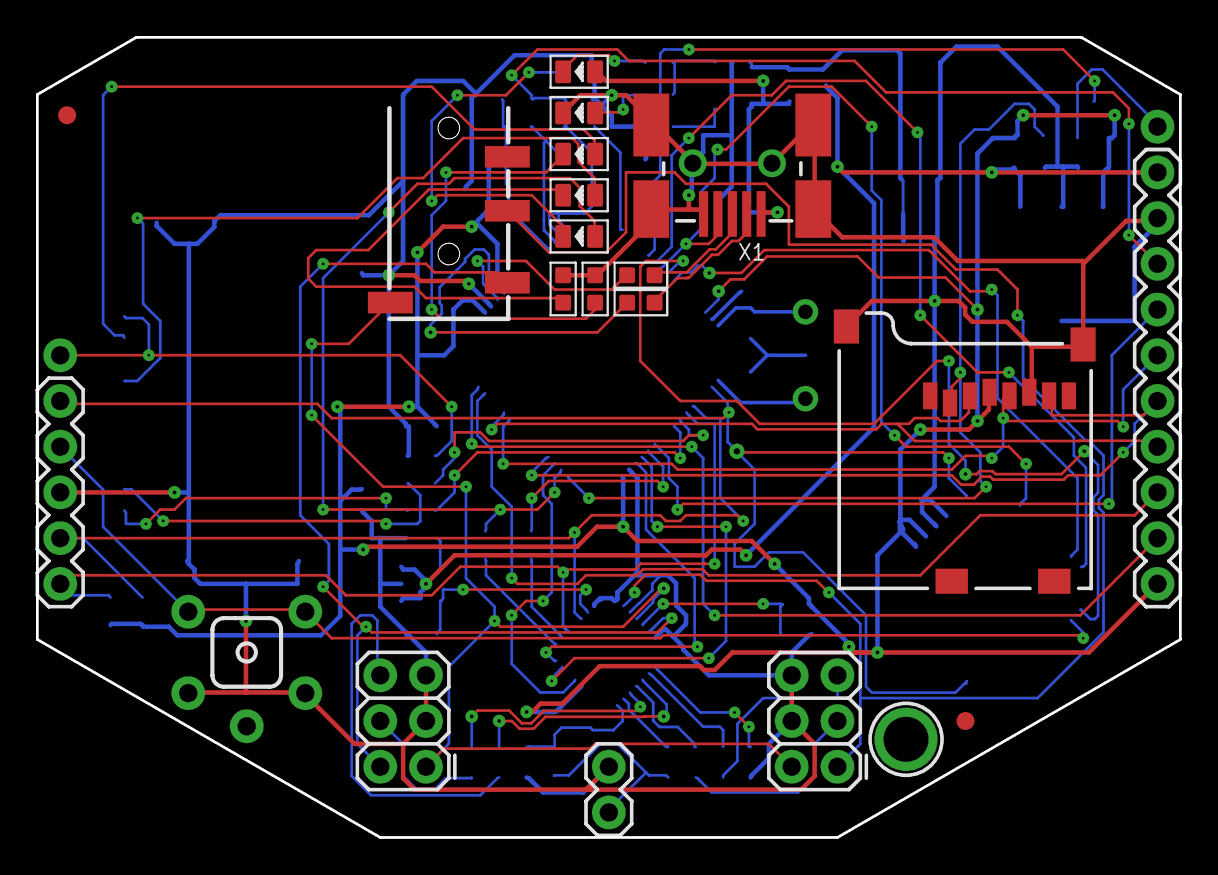
[picture p68: board AugmentedStethoscope_v7.brd from above]

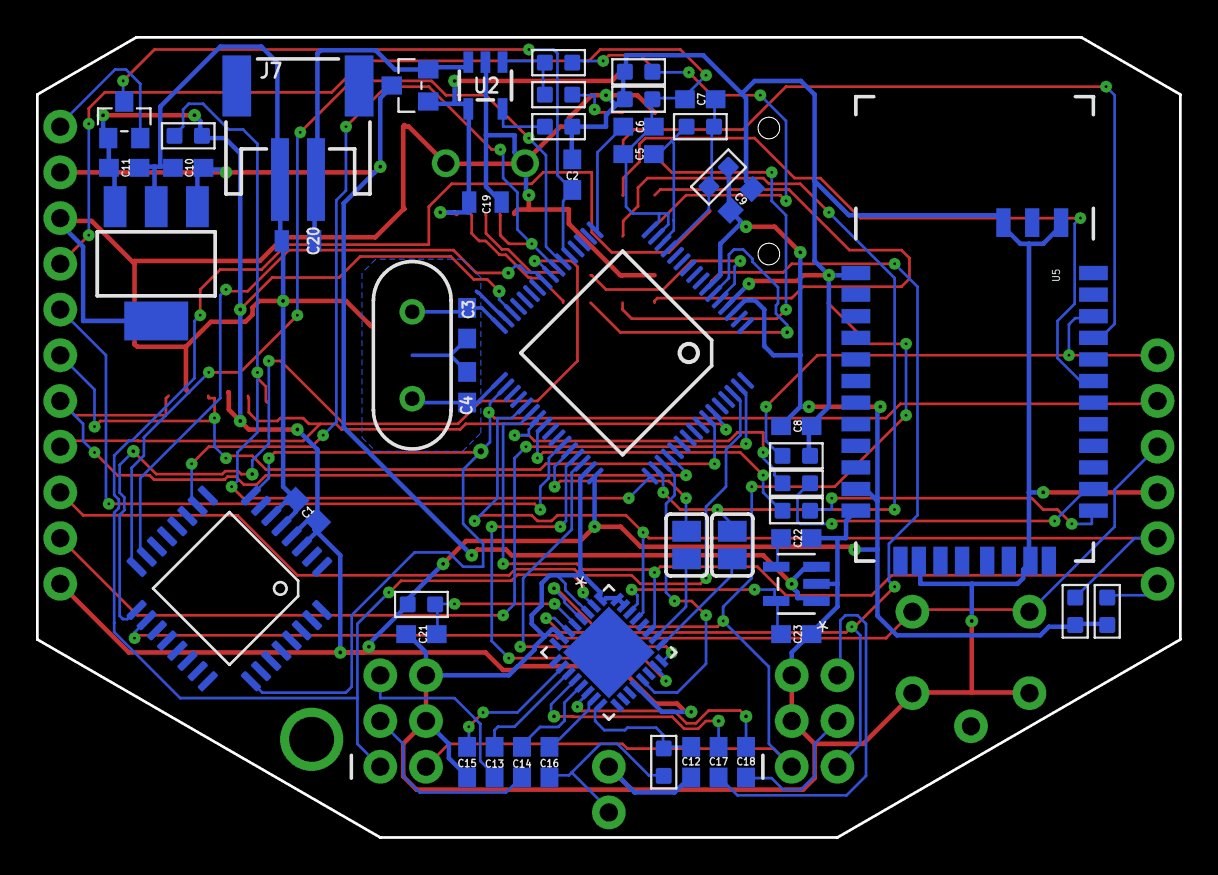
[picture p69: board AugmentedStethoscope_v7.brd from below]

Board: 2 copper layers, 63.5 x 44.5 mm, 74 parts (52 on the bottom side), 71 nets.
