dash-orlando/AugmentedStethoscope/Hardware/STET004/Eagle/AugmentedStethoscope_v2c.brd

## EAGLE design Hardware/STET004/Eagle/AugmentedStethoscope_v2c.brd (2019-04-03)

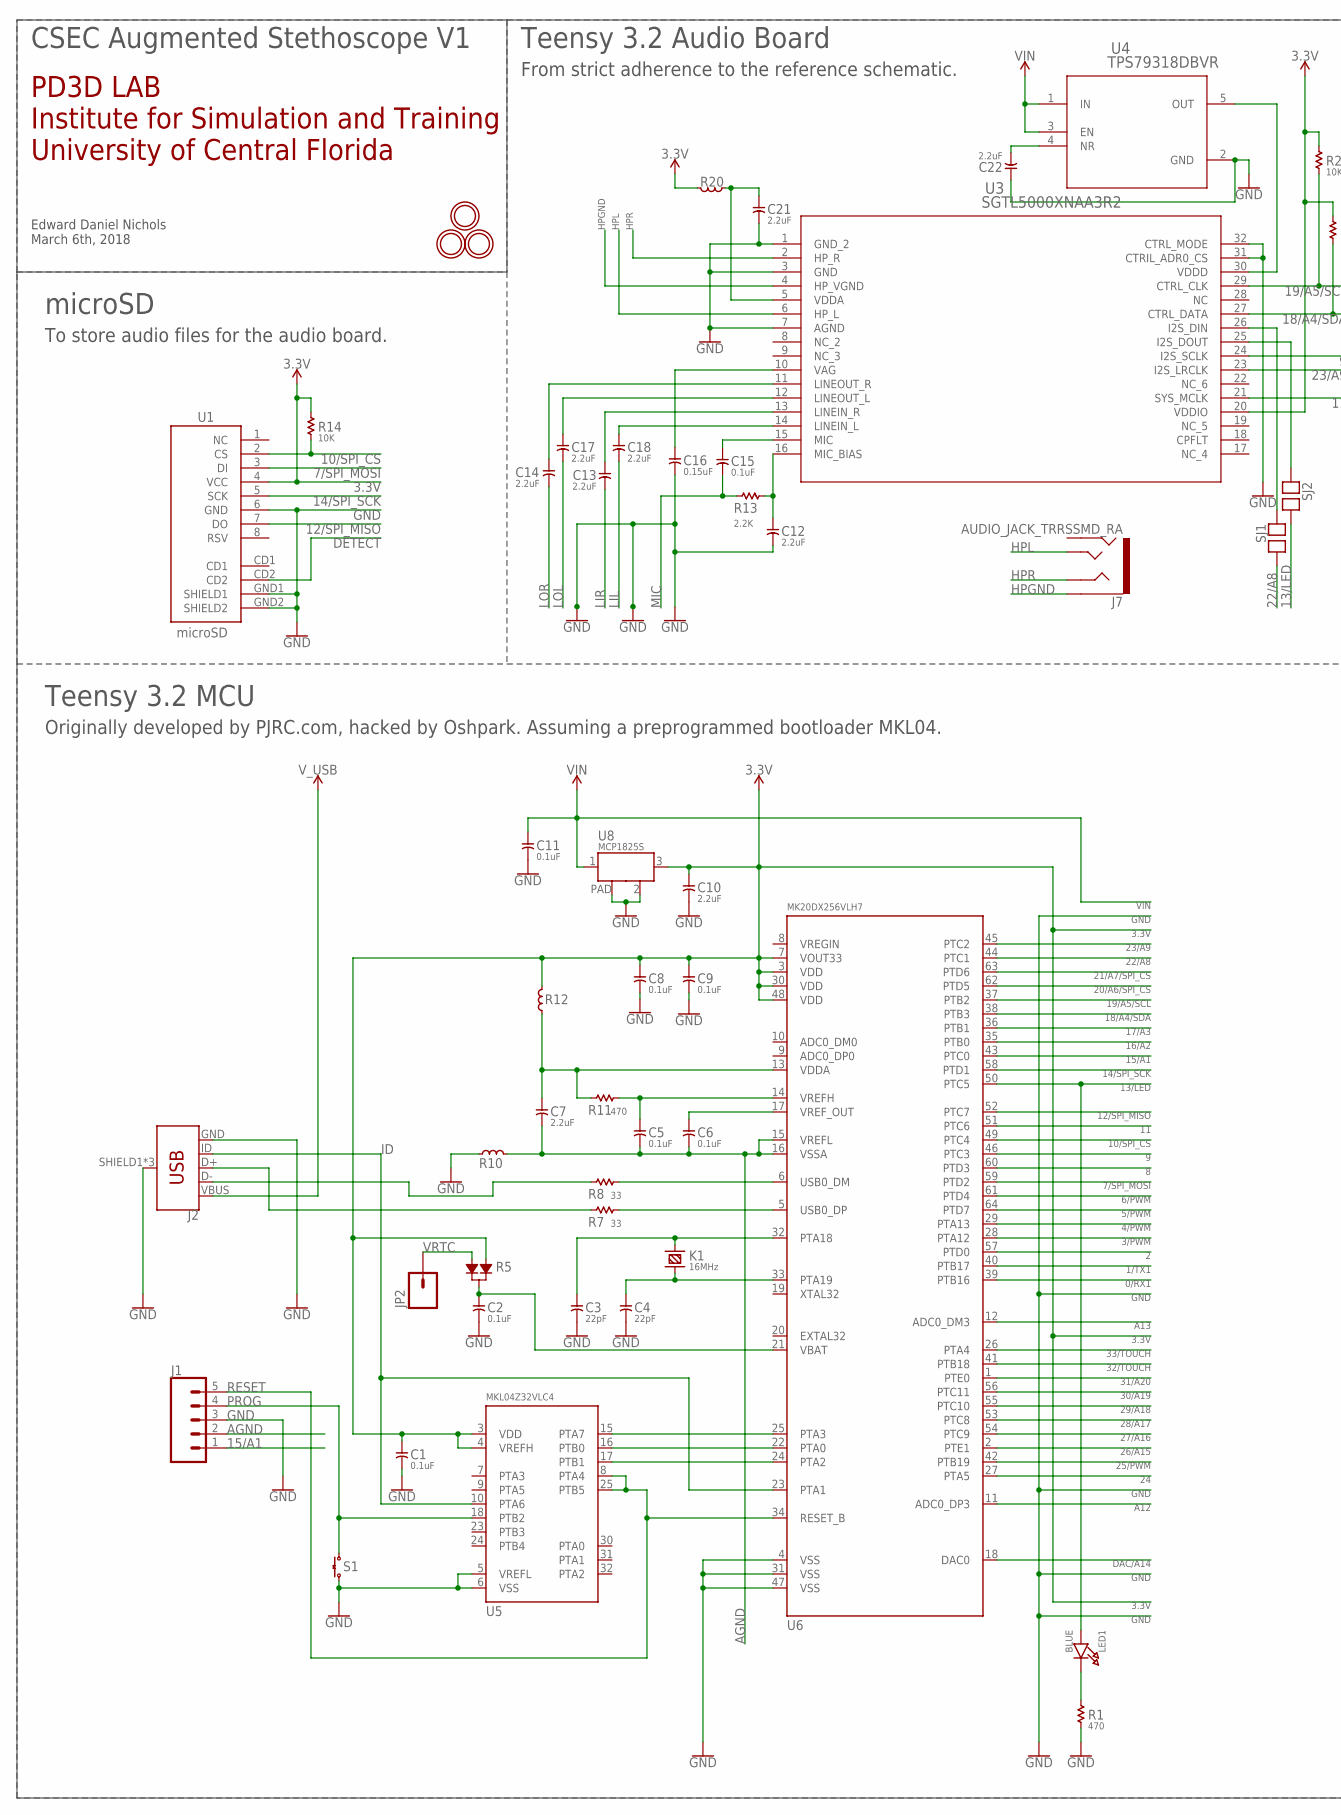
[picture p70: schematic AugmentedStethoscope_v2c.sch, part in row 1, column 1]

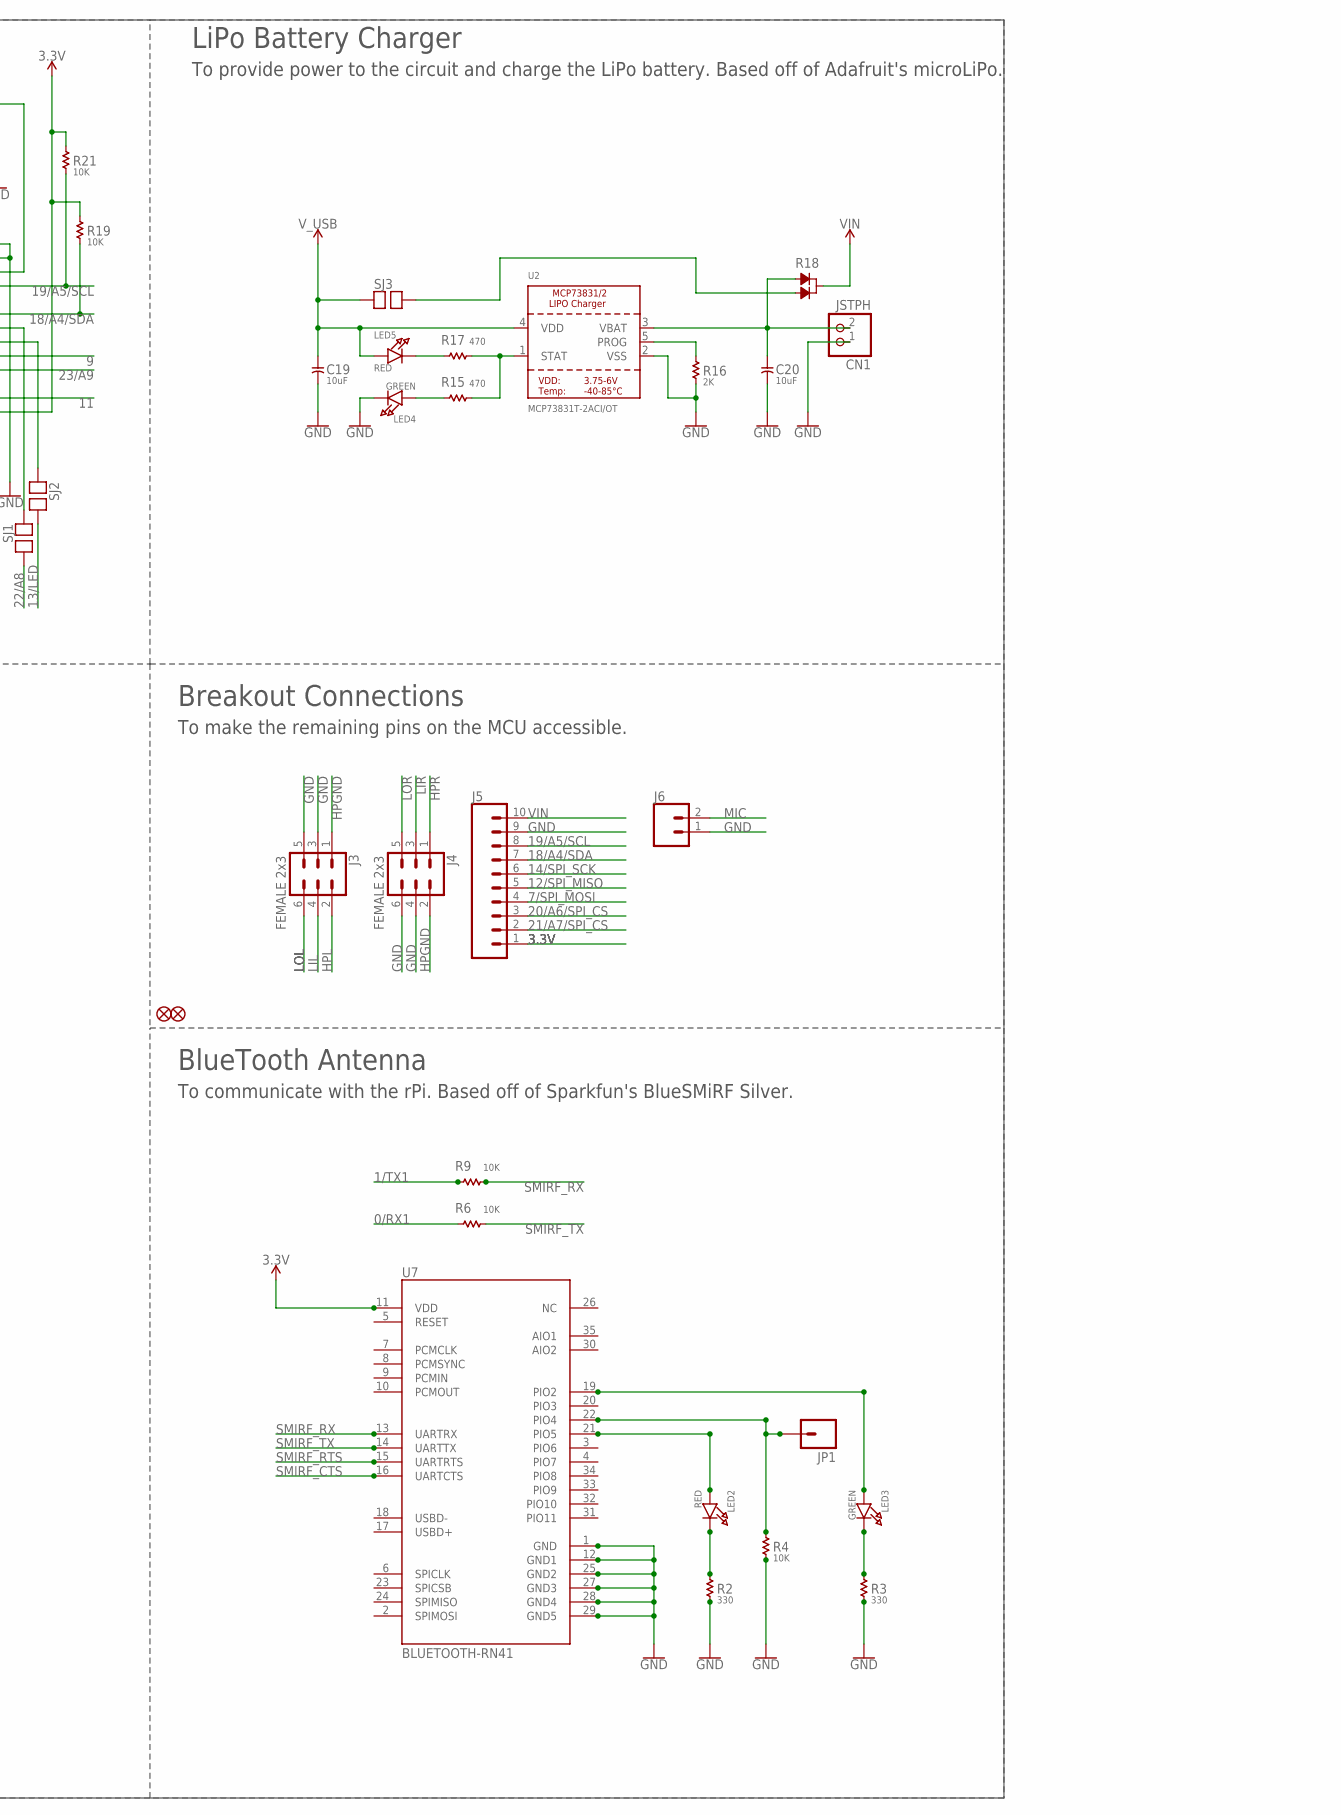
[picture p71: schematic AugmentedStethoscope_v2c.sch, part in row 1, column 2]

Parts:
C1, C2, C5, C6, C8, C9, C11: 0.1uF; C0603
C3, C4: 22pF; C0603
C7, C10, C12, C13, C14, C17, C18, C21, C22: 2.2uF; C0805
C15: 0.1uF; C0805
C16: 0.15uF; C0603
C19, C20: 10uF; C0603
CN1: JSTPH; JSTPH2
FID2, FID3: FIDUCIAL""; FIDUCIAL_1MM
J1: CONN_05; 1X05
J2: USB_MICRO-B_FEMALE-SMT; USB-B-MICRO-SMD
J3, J4: FEMALE 2x3; 2X3
J5: CONN_10"; 1X10
J6: CONN_02; 1X02
J7: AUDIO_JACK_TRRSSMD_RA; AUDIO_JACK_3.5MM_TRRS_SMD_RA
JP1, JP2: M01SMDNS; 1X01NS
K1: 16MHz; HC49US
LED1: BLUE; CHIPLED_0805
LED2, LED5: RED; CHIPLED_0805
LED3, LED4: GREEN; CHIPLED_0805
R1, R11, R15, R17: 470; R0603
R2, R3: 330; R0603
R4, R6, R9, R14, R19, R21: 10K; R0603
R5, R18: DIODE_DUAL; SOT-23
R7, R8: 33; R0603
R10, R12, R20: FERRITE; L0603
R13: 2.2K; R0603
R16: 2K; R0603
S1: TACT_SWITCH; ALPS_SKHH
SJ1, SJ2, SJ3: SOLDERJUMPER
U1: microSD; MICRO-SD-SOCKET-PP
U2: MCP73831T-2ACI/OT; SOT23-5
U3: SGTL5000XNAA3R2; QFN32
U4: TPS79318DBVR; DBV5
U5: MKL04Z32VLC4; LQFP32-08
U6: MK20DX256VLH7; LQFP64-05
U7: BLUETOOTH-RN41; RN41
U8: MCP1825S; SOT-223
U$1, U$3, U$15: MOUNTINGHOLE2.5; MOUNTINGHOLE_2.5_PLATED

Connections:
0/RX1: R6.1, U6.39 (PTB16)
1/TX1: R9.1, U6.40 (PTB17)
2: U6.57 (PTD0)
3.3V: C1.1, C8.1, C9.1, C10.1, J5.1, R5.1, R12.2, R14.2, R19.2, R20.2, R21.2, U1.4 (VCC), U3.20 (VDDIO), U5.3 (VDD), U5.4 (VREFH), U6.3 (VDD), U6.7 (VOUT33), U6.30 (VDD), U6.48 (VDD), U7.11 (VDD), U8.3 (OUT)
3/PWM: U6.28 (PTA12)
4/PWM: U6.29 (PTA13)
5/PWM: U6.64 (PTD7)
6/PWM: U6.61 (PTD4)
7/SPI_MOSI: J5.4, U1.3 (DI), U6.59 (PTD2)
8: U6.60 (PTD3)
9: U3.24 (I2S_SCLK), U6.46 (PTC3)
10/SPI_CS: R14.1, U1.2 (CS), U6.49 (PTC4)
11: U3.21 (SYS_MCLK), U6.51 (PTC6)
12/SPI_MISO: J5.5, U1.7 (DO), U6.52 (PTC7)
13/LED: LED1.A, SJ2.2, U6.50 (PTC5)
14/SPI_SCK: J5.6, U1.5 (SCK), U6.58 (PTD1)
15/A1: J1.1, U6.43 (PTC0)
16/A2: U6.35 (PTB0)
17/A3: U6.36 (PTB1)
18/A4/SDA: J5.7, R19.1, U3.27 (CTRL_DATA), U6.38 (PTB3)
19/A5/SCL: J5.8, R21.1, U3.29 (CTRL_CLK), U6.37 (PTB2)
20/A6/SPI_CS: J5.3, U6.62 (PTD5)
21/A7/SPI_CS: J5.2, U6.63 (PTD6)
22/A8: SJ1.2, U6.44 (PTC1)
23/A9: U3.23 (I2S_LRCLK), U6.45 (PTC2)
24: U6.27 (PTA5)
25/PWM: U6.42 (PTB19)
26/A15: U6.2 (PTE1)
27/A16: U6.54 (PTC9)
28/A17: U6.53 (PTC8)
29/A18: U6.55 (PTC10)
30/A19: U6.56 (PTC11)
31/A20: U6.1 (PTE0)
32/TOUCH: U6.41 (PTB18)
33/TOUCH: U6.26 (PTA4)
A12: U6.11 (ADC0_DP3)
A13: U6.12 (ADC0_DM3)
AGND: C5.2, C6.2, C7.2, J1.2, R10.2, U6.15 (VREFL), U6.16 (VSSA)
D3: LED2.C, R2.2
D4: LED3.C, R3.2
D+: J2.D+, R7.1
D-: J2.D-, R8.1
DAC/A14: U6.18 (DAC0)
DETECT: U1.CD2
GND: C1.2, C2.2, C3.2, C4.2, C8.2, C9.2, C10.2, C11.2, C12.2, C16.2, C19.2, C20.2, C21.2, C22.1, CN1.1, J1.3, J2.GND, J2.SHIELD1 (SHIELD), J2.SHIELD2 (SHIELD), J2.SHIELD3 (SHIELD), J3.3, J3.5, J4.4, J4.6, J5.9, J6.1, LED4.C, R1.1, R2.1, R3.1, R4.1, R10.1, R16.1, S1.3, S1.4 (3), U1.6 (GND), U1.GND1 (SHIELD1), U1.GND2 (SHIELD2), U2.2 (VSS), U3.1 (GND_2), U3.3 (GND), U3.7 (AGND), U3.31 (CTRIL_ADR0_CS), U3.32 (CTRL_MODE), U4.2 (GND), U5.5 (VREFL), U5.6 (VSS), U6.4 (VSS), U6.31 (VSS), U6.47 (VSS), U7.1 (GND), U7.12 (GND1), U7.25 (GND2), U7.27 (GND3), U7.28 (GND4), U7.29 (GND5), U8.2 (GND), U8.PAD
HPGND: J3.1, J4.2, J7.EARTH, U3.4 (HP_VGND)
HPL: J3.2, J7.TIP, U3.6 (HP_L)
HPR: J4.1, J7.RING1, U3.2 (HP_R)
ID: J2.ID, U5.10 (PTA6), U6.23 (PTA1)
LIL: C18.2, J3.4
LIL_ISO: C18.1, U3.14 (LINEIN_L)
LIR: C13.2, J4.3
LIR_ISO: C13.1, U3.13 (LINEIN_R)
LOL: C17.2, J3.6
LOL_ISO: C17.1, U3.12 (LINEOUT_L)
LOR: C14.2, J4.5
LOR_ISO: C14.1, U3.11 (LINEOUT_R)
MIC: C15.2, J6.2, R13.1
MIC_BIAS: C12.1, R13.2, U3.16 (MIC_BIAS)
unnamed: C20.1, CN1.2, R18.1, U2.3 (VBAT)
unnamed: U5.16 (PTB0), U6.22 (PTA0)
unnamed: U5.17 (PTB1), U6.24 (PTA2)
unnamed: C16.1, U3.10 (VAG)
unnamed: C3.1, K1.1, U6.32 (PTA18)
unnamed: C4.1, K1.2, U6.33 (PTA19)
unnamed: C5.1, R11.2, U6.14 (VREFH)
unnamed: C22.2, U4.4 (NR)
unnamed: SJ1.1, U3.26 (I2S_DIN)
unnamed: R7.2, U6.5 (USB0_DP)
unnamed: C6.1, U6.17 (VREF_OUT)
unnamed: U3.30 (VDDD), U4.5 (OUT)
unnamed: SJ2.1, U3.25 (I2S_DOUT)
unnamed: R8.2, U6.6 (USB0_DM)
unnamed: C7.1, R11.1, R12.1, U6.13 (VDDA)
unnamed: R18.2, SJ3.2
unnamed: LED1.C, R1.2
unnamed: C2.1, R5.3, U6.21 (VBAT)
unnamed: U5.15 (PTA7), U6.25 (PTA3)
unnamed: LED5.C, R17.1
unnamed: R15.2, R17.2, U2.1 (STAT)
unnamed: LED2.A, U7.21 (PIO5)
unnamed: LED3.A, U7.19 (PIO2)
unnamed: R16.2, U2.5 (PROG)
unnamed: LED4.A, R15.1
unnamed: C21.1, R20.1, U3.5 (VDDA)
unnamed: C15.1, U3.15 (MIC)
PIO4: JP1.1, R4.2, U7.22 (PIO4)
PROG: J1.4, S1.1, S1.2 (1), U5.18 (PTB2)
RESET: J1.5, U5.8 (PTA4), U5.25 (PTB5), U6.34 (RESET_B)
SMIRF_CTS: U7.16 (UARTCTS)
SMIRF_RTS: U7.15 (UARTRTS)
SMIRF_RX: R9.2, U7.13 (UARTRX)
SMIRF_TX: R6.2, U7.14 (UARTTX)
VIN: C11.1, J5.10, R18.3, U4.1 (IN), U4.3 (EN), U8.1 (IN)
VRTC: JP2.1, R5.2
V_USB: C19.1, J2.VBUS, LED5.A, SJ3.1, U2.4 (VDD)

Notes on the sheet:
Teensy 3.2 MCU
Originally developed by PJRC.com, hacked by Oshpark. Assuming a preprogrammed bootloader MKL04.
microSD
To store audio files for the audio board.
Breakout Connections
To make the remaining pins on the MCU accessible.
BlueTooth Antenna
To communicate with the rPi. Based off of Sparkfun's BlueSMiRF Silver.
Teensy 3.2 Audio Board
From strict adherence to the reference schematic.
LiPo Battery Charger
To provide power to the circuit and charge the LiPo battery. Based off of Adafruit's microLiPo.
PD3D LAB Institute for Simulation and Training University of Central Florida
CSEC Augmented Stethoscope V1
Edward Daniel Nichols March 6th, 2018

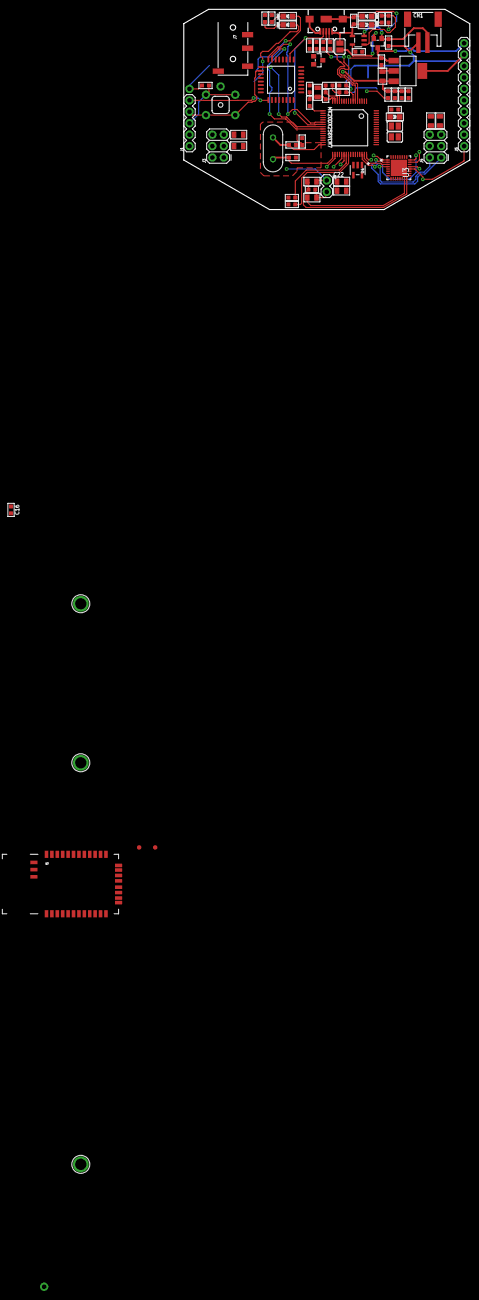
[picture p72: board AugmentedStethoscope_v2c.brd from above]

Board: 2 copper layers, 63.5 x 44.5 mm, 76 parts (1 on the bottom side), 72 nets.
