dash-orlando/AugmentedStethoscope/Software/Arduino/Stethoscope/KorotkoffSound.cpp

// Audio data converted from WAV file by wav2sketch

#include "KorotkoffSound.h"

// Converted from KorotkoffSound.wav, using 44100 Hz, u-law encoding
const unsigned int KorotkoffSound[11873] = {
0x0100B974,0x15141514,0x15141414,0x15151515,0x16161516,0x16161616,0x17161716,0x18171816,
0x18181817,0x19181818,0x19191919,0x1A191919,0x1A191A19,0x1A1A1A1A,0x1B1B1A1A,0x1B1B1B1B,
0x1D1D1C1C,0x1E1E1D1D,0x1F1F1F1E,0x20202020,0x21212020,0x21212121,0x22212121,0x22222221,
0x22222222,0x23232322,0x23232323,0x24232423,0x24242424,0x25242424,0x25252525,0x26252525,
0x26262626,0x26262626,0x26262626,0x26262626,0x26262626,0x26262626,0x25262626,0x25252526,
0x25252525,0x25252525,0x25252525,0x25252525,0x25252525,0x25252525,0x25252525,0x25252525,
0x25252525,0x25252525,0x25252525,0x26262525,0x26262626,0x27272727,0x28282827,0x29282828,
0x29292929,0x2A292929,0x2A2A2A2A,0x2B2A2A2A,0x2B2B2B2A,0x2C2C2B2B,0x2D2C2C2C,0x2E2D2D2D,
0x2F2E2E2E,0x3030302F,0x30303030,0x31313131,0x32323231,0x33323232,0x33333333,0x34343434,
0x35343434,0x35353535,0x36363535,0x36363636,0x37373737,0x38383737,0x39383838,0x39393939,
0x3A3A3A39,0x3B3A3A3A,0x3B3B3B3B,0x3C3C3C3B,0x3D3D3C3C,0x3E3E3D3D,0x3F3E3E3E,0x40403F3F,
0x40404040,0x41414040,0x41414141,0x42424242,0x43424242,0x43434343,0x44444443,0x44444444,
0x45454545,0x45454545,0x46464645,0x46464646,0x47464646,0x47474747,0x48484747,0x48484848,
0x49494848,0x49494949,0x4A4A4A49,0x4A4A4A4A,0x4B4B4B4A,0x4B4B4B4B,0x4C4C4C4B,0x4C4C4C4C,
0x4D4D4C4C,0x4D4D4D4D,0x4D4D4D4D,0x4E4E4E4D,0x4E4E4E4E,0x4E4E4E4E,0x4F4F4E4E,0x4F4F4F4F,
0x4F4F4F4F,0x4F4F4F4F,0x504F4F4F,0x50505050,0x50505050,0x50505050,0x50505050,0x50505050,
0x50505050,0x50505050,0x50505050,0x50505050,0x50505050,0x50505050,0x50505050,0x50505050,
0x50505050,0x50505050,0x50505050,0x4F504F50,0x4F4F4F4F,0x4F4F4F4F,0x4F4F4F4F,0x4F4F4F4F,
0x4E4E4E4F,0x4E4E4E4E,0x4E4E4E4E,0x4D4D4E4E,0x4D4D4D4D,0x4D4D4D4D,0x4C4C4C4D,0x4C4C4C4C,
0x4C4C4C4C,0x4B4B4C4C,0x4B4B4B4B,0x4B4B4B4B,0x4A4B4B4B,0x4A4A4A4A,0x4A4A4A4A,0x49494A4A,
0x49494949,0x48494949,0x48484848,0x47484848,0x47474747,0x46474747,0x46464646,0x45464646,
0x45454545,0x45454545,0x44444444,0x44444444,0x43434343,0x42434343,0x42424242,0x42424242,
0x41414141,0x41414141,0x40404040,0x3F404040,0x3E3E3F3F,0x3D3E3E3E,0x3C3D3D3D,0x3B3C3C3C,
0x3A3B3B3B,0x393A3A3A,0x38393939,0x37383838,0x36373737,0x35363636,0x35353535,0x34343434,
0x33333334,0x33333333,0x32323232,0x31323232,0x31313131,0x30303031,0x30303030,0x2F2F2F2F,
0x2D2E2E2E,0x2C2C2D2D,0x2B2B2B2C,0x292A2A2A,0x28292929,0x27282828,0x27272727,0x27262727,
0x27272726,0x27272727,0x28272727,0x28282828,0x29292928,0x2A2A2A29,0x2B2B2B2B,0x2D2C2C2C,
0x2E2E2E2D,0x302F2F2E,0x30303030,0x31313130,0x32313131,0x32323232,0x33333333,0x34343433,
0x35353434,0x36353535,0x37363636,0x37373737,0x38383838,0x39393938,0x3A3A3A39,0x3B3B3A3A,
0x3C3C3B3B,0x3D3D3C3C,0x3D3D3D3D,0x3E3E3E3E,0x3F3F3E3E,0x3F3F3F3F,0x403F3F3F,0x40404040,
0x40404040,0x40404040,0x40404040,0x40404040,0x40404040,0x40404040,0x40404040,0x40404040,
0x40404040,0x3F3F4040,0x3F3F3F3F,0x3E3E3E3F,0x3E3E3E3E,0x3D3D3D3D,0x3C3C3D3D,0x3B3C3C3C,
0x3B3B3B3B,0x3A3A3A3A,0x39393939,0x37383838,0x36363737,0x35353636,0x34343435,0x33333333,
0x32323232,0x31313131,0x2F303030,0x2D2E2F2F,0x2B2C2C2D,0x29292A2B,0x27272828,0x24252526,
0x21222323,0x1F202021,0x1A1B1C1E,0x15171719,0x11121314,0x0A0B0E10,0x02030607,0x86848280,
0x8F8C8B88,0x94939290,0x99979695,0x9E9C9B9A,0xA1A0A09E,0xA3A3A2A1,0xA6A5A5A4,0xA9A8A7A7,
0xABABAAA9,0xAEADADAC,0xB0B0AFAF,0xB2B1B1B0,0xB3B3B2B2,0xB4B4B4B3,0xB6B6B5B5,0xB8B7B7B6,
0xB9B9B8B8,0xBBBABAB9,0xBCBCBBBB,0xBEBDBDBC,0xBFBFBEBE,0xC0C0C0C0,0xC1C1C1C0,0xC2C2C1C1,
0xC3C3C2C2,0xC4C3C3C3,0xC5C4C4C4,0xC6C5C5C5,0xC6C6C6C6,0xC7C7C7C7,0xC8C8C8C8,0xC9C9C9C8,
0xCAC9C9C9,0xCACACACA,0xCBCBCBCB,0xCCCCCCCB,0xCDCCCCCC,0xCECDCDCD,0xCECECECE,0xCFCFCFCF,
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
};
