dash-orlando/AugmentedStethoscope/(commit log)

2015-10-23 New script - search for desired bluietooth device
2015-10-23 variables changed from "devices" to "btdevices"
2015-10-26 Created function to record sound from input device connected to computer
2015-10-26 Created a function to allow for the user to select the input recording device
2015-10-27 Function design to execute the recording from a selected input recording device
2015-10-27 Converted script into function and added switches to execute the recording
2015-10-27 Added the variable status, which represents the action taken by the user on the dialog box. If the user makes a successful selection, status is equal to one. In the opposite case, which may lead to e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
2015-10-29 Created a function for the power spectral density analysis of the heart sounds
2015-11-17 Generated short function that searches for the bluetooth devices connected to the PC
2015-11-17 Created a short function that allows for the user to select the bluetooth device to pair to
2015-11-17 Created function to search for available audio recording devices within the computer
2015-11-17 Created new function for the user to select the preferred audio recording device
2015-11-17 Created function that connects to a selected audio recording device through the creation of a recording object
2015-11-17 Added the device id within the output structure array of the audio recording selection function. The id is needed in order to create a recording object within MATLAB.
2015-11-18 Created function to search for connected playback devices
2015-11-18 Created function to allow for user to select the preferred audio playback device
2015-11-18 Added command line messages to update current status of the program
2015-11-18 Created function to create audio playback device or player
2015-11-18 Corrected program to look for output devices
2015-11-18 Generating the graphical user interface for the splits demo/prototype
2015-11-18 Added three buttons and three status text windows. The buttons allow for the user to search, select, and connect to a bluetooth device
2015-11-18 Added to toggle buttons and began playing with their visibility properties. These buttons should be activated only after a device has been successfully connected to the computer
2015-11-19 Added functionality to 'record' and 'playback' toggle buttons. These buttons will, primarily, show/hide the controls for recording or playing audio back. These functions cannot be used simultaneously.
2015-11-19 Added more functions to the toggle buttons
2015-11-19 Specified more actions under the toggle buttons, specifically defining the visibility of other objects. Additionally, the connect to audio input device button and status window were added
2015-11-20 Added functionality to the start and stop recording buttons.
2015-11-20 Added display and write buttons and began working on the functionality of the display function
2015-11-20 Expanded on the visibility of recording controls on the press of the record toggle button
2015-11-20 Added comments to the write pushbutton callback. Stored hardware information from recording device to the handles structure.
2015-11-20 Modified sampling frequency variable for the correct case-sensitive structure array variable expected
2015-11-20 Added the buttons and text for the playback features
2015-11-20 Began integrating functionality within each playback button and/or feature. Eliminated the stop button as there is no current need to stop during playback. Full controls, including pause and stop sho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
2015-11-20 Added radio buttons and edit boxes to allow users to select between a single iteration of the playback or multiple
2015-11-23 Added conditional statement (if) for the case were no recording devices are actually connected to the control system
2015-11-23 Divided script into clear sections using comments (ease the reading and debugging process). Added time vector to the display function of the recording feature. Eliminated the titles for each record f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
2015-11-23 Changed the visibility of the display and write functions to be dependent on the status of the start and stop buttons within the recording feature of the gui. Added comments on the display section.
2015-11-23 Included the visibility of the recording status text and title into the connect to recording device button executions
2015-11-23 Expanded on the visibility function of the toggle buttons.
2015-11-23 Modified message on audio playback device search function
2015-11-23 Fixed visibility call. Fixed string target. Added comments and corrected function call on audio playback device select button.
2015-11-25 Added functionality to the start playback button on the graphical user interface. Given the alternatives for single and looped playback, the execution consists of multiple conditional statements.
2015-11-25 Modified the interaction between the multiple repetition radio buttons and the start playback button. Now, only when the input to the radio button is a number the start button will play the sound. Ot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
2015-11-26 Created conditional loop to account for the case in which the user cancels/exits the file browser
2015-11-29 Added documentation relevant to the programs in current development
2015-11-29 Created a function to determine the appropriate length of discrete Fourier transforms, based on the length of an input signal (length in # of samples)
2015-11-30 Added command window messages to report status of the function, like program completion or current execution step. Expanded conditional statement for visualization to the the 'off' case.
2016-01-14 Created folders for Arduino and Processing scripts. Populated these directories with basic examples. Some of these examples will be later replaced by algorithms specific to thebeat project
2016-01-19 Created example code for lighting an LED through processing
2016-02-23 Created subdirectories, within the MATLAB folder, to store programs on the basis of their use/purpose. For instance, analysis codes are used separately from the gui and the filtering functions. Howev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
2016-02-23 Created a documentation folder within the Filtering directory. This folder will contain any reference material that supports the logic, functions, and theory implemented in the algorithms.
2016-04-19 Updated the StandardFirmata Arduino file and added a stetControl script that will be used to test the connected hardware (sensors, arduino, and bluetooth connectivity).
2016-04-20 Created a directory for the information on every prototype developed for "thebeat" project. In this commit a BOM list was uploaded to the directory for the "stet001" concept.
    [BOM.csv]
2016-04-20 Updated the BOM file with a total section for a summarized total cost and total item quantity.
    [BOM.csv]
2016-04-20 Created a short software manual for the software configuration of the prototype.
2016-04-20 Eliminated the findMinValue function as this wont be needed for this iteration of the prototype stage.
2016-04-22 Decided to begin using processing to create the control algorithms instead of relying on the Arduino IDEs and scripts. This decision was made given the fact that the serial monitor cannot be accessed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
2016-04-22 Added press enter as an alternative to the step press send, when communicating using the Arduino serial monitor window
2016-04-22 Started a section on the software guide dedicated to configuring the arduino board.
2016-04-22 Made additions to the arduino configuration section
2016-04-23 Created a processing script, called "stetControl", in order to connect, acquire, and process sensor data collected by the Arduino on the stethoscope prototype.
2016-04-23 Created a serial connection function, based on the original "connect2Arduinos" function developed for the Control System repo, which uses the exact name of the port instead of the number of Arduinos 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
2016-04-24 Created, implemented and validated function to read and print the analog pin data from the connected Arduino. The function "readAnalogDataSimple" represents a simplified version of the "readAnalogDat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
2016-05-17 Downloaded the WAVE Shield assembly and implementation guide made by Adafruit. Stored the guide within the Documentation/Guide directory in the thebeat repo.
2016-05-17 Included both the adavoice and WaveHC libraries, build by Adafruit, to the Arduino directory of the repository.
2016-05-17 Starting from the adavoice_face arduino demo, a program that only modifies the input audio was created. In this code, the commands SD card reading were also removed.
2016-06-02 Completed the newest status report for the stethoscope prototype.
2016-07-26 Added the programs developed on the teensy for the july demo of the stethoscope. All of the development on these programs was done by Michael X.
    [diff.txt]
2016-08-29 Added a microphone free-run program to test audio capabilities of the teensy
2016-08-29 Began developing the bluetooth data communication protocols between the Teensy and the RPi. The code uploaded here is a demo code to establish serial communication.
2016-08-30 Re-organized the repository to match the structure of other csec repositories
    [BOM.csv, diff.txt]
2016-08-30 Added a Python directory under Software and a bluetooth communication demo program. This program will be the foundation of the bluetooth communication between the teensy and the control system.
2016-08-30 Added and modified two serial communication codes that will manage bluetooth communication on the teensy.
2016-08-31 Initial contribution of stethoscope Arduino files to repository. Version is 0.01
2016-08-31 Added comments to the Bluetooth data relay code - work in progress
2016-08-31 Made quick modification for two-way communication with the bluetooth antenna on the teensy prototype
2016-09-21 Continued to play with the different serial ports within the Teensy board. Still not having success enabling multiple ports without affecting the audio shield and the regular serial monitor communica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
2016-09-26 Commented the serial port pin definitions and replaced the Serial2 variable for Serial1 in order to transmit data, wirelessly through these pins.
    [Stethoscope.ino, protocol.h]
2016-09-27 Created a new branch dedicated to control debugging mode remotely. Debugging was hardcoded within the original Arduino script and depended on a serial monitor. Bluetooth communication could not begin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
2016-09-27 Eliminated all instances checking for the DEBUG flag. The device will now perform a system check automatically and the user may trigger one remotely.
2016-09-27 Began changing the stethoscope code by eliminating sections related to the DEBUG statement and the SD card check under the setup loop. Note that the SD card check was performed immediately originally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
    [Stethoscope.ino]
2016-09-27 Eliminated calls to the LED/Buttons library. This library was developed for prototypes using LEDs and buttons for commands and cues. The final product wont have any user interface so this library won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
2016-09-28 Eliminating unecessary/additional serial printed messages.
2016-09-29 Modified and simplified the serial print sections of the code
2016-10-12 Uploaded PCB files for the STET002
    [STET002.fzz]
2016-10-12 Added production files for the STET002 prototype
    [STET002.fzz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]
2016-10-12 Modified the silk screen of the PCB design to reflect part labels. All files were re-exported.
    [STET002.fzz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]
2016-10-18 Added modification needed to run the audio board properly. Changes made by MX.
2016-10-20 Re-organized the Software/Arduino directory to place all unused programs in a legacy folder
    [diff.txt]
2016-10-20 Eliminated functions pertaining to the direct communication with the bluetooth antenna. These codes were made by MX.
2016-10-20 Began working on a new convention for the communication functions that will be used across all of our prototypes.
2016-10-20 Created a new script that will consolidate the functions that are called by the device control 1 set of commands.
2016-11-02 Began modifying the stethoscope arduino functions to add communication and reporting
2016-11-02 Added comments to the start-recording function. Changed some of the text within the serial-print statements.
2016-11-04 Added the configuration file protocol. This protocol will be used to pass data structures into the device functions.
2016-11-07 Created a new diagnostic function called device identification. This function will be used to request the id/name of the device when attempting to pair.
2016-11-09 Modified the audio library of the repo to include a .raw extension of the normal heart beat sound file. Our prototype only reads .raw extensions.
2016-11-09 Fixed an issue with the variable structure created in the configuration file and used to pass file names into other functions
    [Config.h, DeviceSpecificFunctions.h, Stethoscope.ino]
2016-11-09 Updated the teensy-audio parameters that control the microphone and audio outputs.
2016-11-10 Made changes to the parse-byte code to include all the device-specific functions to date.
2016-11-16 Began modifying volume and gain parameters, on the assembled stethoscope prototype, for better quality sound. Initial trial suggest the need of a filter.
2016-11-16 Increased the gain of the mixer in order to amplify the signal captured by the microphone. Still in need of a filter.
2016-11-18 Using a legacy code for testing, a new wiring/configuration file was created for the audio card that allow for filtering of the input signal.
2016-11-28 Made some final modifications to print the heart-rate to the serial monitor.
2016-11-28 Modified the output of the serial frame library to be a string instead of a byte.
2017-01-31 Created a new dev branch that reverts the stethoscope code to a single byte communication method.
    [DeviceSpecificFunctions.h, TeensyAudio.h]
2017-01-31 Replaced the parse-byte and protocol files with their branch-specific counterparts.
    [parseBtByte.h, protocol.h]
2017-02-01 Successfully added the frame function that prints the heart rate to the tracking and the recording functions of the stethoscope.
2017-02-01 Established great sensitivity and volume levels for the current stethoscope prototype.
2017-03-07 Updated to include stereo headphone pogo pins and route output to .1" header connector.
    [STET002.fzz, pcb_top.dxf]
2017-03-08 Added gerber files for the new PCB developed by MX.
    [STET002_contour.gm1, STET002_copperBottom.gbl, STET002_copperTop.gtl, STET002_maskBottom.gbs, STET002_maskTop.gts, STET002_silkBottom.gbo, STET002_silkTop.gto]
2017-04-05 Found and fixed issue with acousti feedback from microphone.
    [BPCuffResponse.h, SimulationFunctions.h, TeensyAudio.h, states.h]
2017-04-06 Changed the microphone volume to enhance the acoustics of the single balanced armature prototype.
2017-05-22 High-shelf filter added to speaker output to attenuate resonate highs.
2017-05-23 Replaced teensyaudio.h file with merging errors with the latest working copy.
    [TeensyAudio.h]
2017-06-20 Replaced Lowpass filter with biquad to implement Butterworth filter (milder frequency rolloff). Refactored remaining audio system object names.
    [BPCuffResponse.h, DeviceSpecificFunctions.h, SimulationFunctions.h, TeensyAudio.h]
2017-06-21 Found and added the missing sections of the recording function that triggered the writing of the data to the SD file.
    [DeviceSpecificFunctions.h]
2017-06-21 Added the correct versions of the stethoscope scripts developed in the master-MX and master-FL branches
    [BPCuffResponse.h, DeviceSpecificFunctions.h, DiagnosticFunctions.h, FileSD.h, SimulationFunctions.h, TeensyAudio.h, parseBtByte.h, protocol.h]
2017-06-22 Commented the debug lines testing the time for data writing onto the on-board SD card.
2017-06-22 Began changing the microphone gain to identify an optimum value. 32 seemed to be below whats needed. Since 34 and 35 led to some clipping, 33 should be tested next.
2017-07-07 Added new playback files, discovered some faults with the current structure of the code. Suggesting review in a separate branch.
2017-07-07 Discovered and fixed the problem with the playback of recordings or other audio files. The filenames need to be 6 characters long.
    [Config.h, DeviceSpecificFunctions.h, parseBtByte.h, protocol.h]
2017-07-07 Visually separated the case statements by function type within the parse bluetooth byte script.
2017-07-18 Added an actual Korotkoff sound to the augmented blood pressure cuff interaction.
2017-07-19 Finished the best current attempt at blending the korotkoff sounds based on pressure readings on the augmented blood pressure cuff.
2017-07-19 This code has been assembled to test the concept of contract free location sensing using magnetometers. Magnetic field vector data for two sensors is pulled from the serial port of an Arduino board. 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
2017-07-19 Commented the mixer level print statement to allow visualization of the rms and peaks from both acoustic inputs.
2017-07-19 Completed a working code for the switching of the overlay audio based of rms from the mic input. Still need to correct by using the threshold value of the rms to ensure complete muting of the channel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
    [DeviceSpecificFunctions.h, TeensyAudio.h]
2017-07-19 Modified the rms amplitude peaks function to return a boolean to start or stop blending. Currently working on the implementation as the function is not working.
2017-07-28 Plotting was disabled. Math was simplified. Arduino code was iterated to output 6 values.
2017-08-09 Added documentation on the stethoscope.
    [Stethoscope Assembly - Assembly Components.xlsx, Stethoscope Assembly - Lab Components.xlsx, Stethoscope Assembly - Preparation Components.xlsx]
2017-08-11 Updates assembly guide and added BOM for the Augmented Stethoscope
    [Augmented Stethoscope BOM.xlsx]
2017-08-14 Get distance from magnet in virtual space
2017-08-18 Improved IMU calibration (less variation)
2017-08-23 Created a new version of the program in order to dissect the issue with the Non-Linear Newton Raphson method. The probelm seemed to be with the precision of the numbers. Changing the arrays to float 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
2017-09-06 Error checks on sensors
2017-09-25 Switch to Teensy + add 4th sensor
2017-09-27 Fixed issue with newline characters not being printed
2017-10-04 VERSION 0.2: - Removed limitation of having to place magnet at a predefined position on startup. - 6 sensors are placed around an ellipse.
2017-10-06 Began developing a program that simulates the initial guesses of the magnetometers based on the shape of the triangulation
2017-10-09 Created a directory for conferences and DMD specifically. The current write-ups will be moved to this directory.
2017-10-09 Began adding corrections/suggestions to the current draft.
2017-10-10 K values for multiple magnets
    [K Values for Multiple Magnets.xlsx]
2017-10-10 Pictures of IMU array & calibration process
2017-10-13 Add files via upload
    Fancy Hi-Res Flowchart for the DMD paper
2017-10-13 K value for spherical magnet
    [K Values for Multiple Magnets.xlsx]
2017-10-16 Plot data + profile the data output rate
    [small magnet, track 2.csv, small magnet, track 2.xlsx, small magnet, track 3.csv, small magnet, track 4.csv, small magnet, track 5.csv, small magnet, track 6.csv, small magnet, track 7.csv, trials, consolidated and plotted.xlsx]
2017-10-20 Add files via upload
    Both addresses are enabled to improve data sampling rates (s.t. half as many MUX switches are necessary).
    The right hand rule was enforced on sensor output to reflect a coordinate system definition that makes physical sense, and is consistent with the rest of the algorithm; the sensor's built-in C.S. was essentially thrown out.
2017-10-20 Add files via upload
    The present version only supports 4 sensors. I will scale this again for more sensors; this may damage the refresh rate.
    Multithreading and data queuing has been implemented, and data output is now in "real time" or > 30Hz.
2017-10-23 Add files via upload
    Working on enabling the two addresses for the IMUs, enforcing a coordinate system, and optimizing the output rate.
2017-10-26 Reverted to old setup
    [small magnet, track 2.csv, small magnet, track 3.csv, small magnet, track 4.csv, small magnet, track 5.csv, small magnet, track 6.csv, small magnet, track 7.csv]
2017-10-26 Make 2 addresses I2C fix provided by Danny backwards compatible
2017-10-26 Modify portions of code to work with 2 I2C addresses
2017-10-30 Add files via upload
    Raw data and processing from which came the accuracy analysis
    [Magnetometer Position Tracking Accuracy and Precision Analysis.xlsx]
2017-10-30 Added documents from the Z drive.
    [data_1.xlsx, data_2.xlsx]
2017-10-30 Result subsection 2 should still be appended.
    We're only missing figures in subsection 2, a final review of the paper, and probably a light reduction of the presented material to be more compliant with DMD's tech brief length limits. We got this.
2017-10-31 Submitted the latest version of the magnetic tracking paper.
    [Magnetometer Position Tracking Accuracy and Precision Analysis.xlsx, Point Accuracy - Large Magent.xlsx, Point Accuracy - Small Magent.xlsx, data_1.xlsx, data_2.xlsx, small magnet, track 2.xlsx, trials, consolidated and plotted.xlsx]
2017-11-01 Updated paper.
    [Point Accuracy - Small Magent.xlsx]
2017-11-01 My final edits have been appended.
    We do have much work to do on this project, but I think this we're in a good spot. Let's cross our fingers and hope they accept the paper.
2017-11-07 Minor restructuring of code
    1- Implemented a more generalized EMA filter.
    2- Reorganized code for easier readability
2017-11-10 Added a picture/figure of the current version of the audio patch diagram.
2017-11-12 Added youtube videos with embedded blood pressure cuff sounds
2017-11-13 Added the serial frame libraries to the main stethoscope arduino directory for ease in the compile process.
2017-11-13 Modified the rms-modulation function to print the rms value for comparison. This revealed that a count-based wait (artificial) stopped the program from switching properly.
2017-11-13 Completed a successful prototype of the rms-modulation of the signal. Need to explore floats for more precision and limits to avoid extreme attenuation or amplification.
    [DeviceSpecificFunctions.h]
2017-11-13 Began integrating a korotkoff blood pressure sound to the library of files
2017-11-13 Enabled the continue blending function to use a filename as an input. In this case, the file is the same that is currently playing.
2017-11-13 Had forgotten to store the return value onto the filename variable after calling the function. The current version of the code works but the audio file needs to be improved.
2017-11-14 Overhauled the wave amplitude peaks v2 function to calculate heart rate. Current limitations are due to the baseline or background noise.
    [DeviceSpecificFunctions.h]
2017-11-14 Moving towards eliminating counters and using only timers.
2017-11-14 Completed the first step towards implementing timers (using elapsedMillis()) for the heart rate monitoring.
2017-11-14 Stored time limits as variables. This was causing issues before, but it was associated with how elapsed millis was called.
    [DeviceSpecificFunctions.h]
2017-12-01 Added serial monitor print statements to verify that string messages were sent correctly.
    [DeviceSpecificFunctions.h]
2018-03-28 Added list of stethoscopes to keep track of production.
    [List of Stethoscopes.xlsx]
2018-04-02 Added documentation referring to the fabrication of 200 stethoscopes
    [STET004 PCB BOM.xlsx]
2018-04-02 Re-organized the hardware directory and placed estimates and information pertaining to the latest PCB design
    [STET004 PCB BOM.xlsx]
2018-04-03 Added additional quotes for fabrication and manufacturing of stethoscope boards
    [47825A1_BOM_VK_2018-04-02.xlsx]
2018-05-02 Moved the serial frame functions to the legacy folder
2018-05-02 Removed the last call remaining to the serial frame library
2018-05-07 Gathered the libraries that are used when compiling the stethoscope script, making the process easier for deployment in other PCs. Note that the call for these libraries have not been changed in the 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
2018-05-07 Began consolidating the device states definitions to a single variable, then went through all of the stethoscope header files to remove calls to variables that were deprecated or removed
2018-05-08 Finished consolidating state definitions through the stethoscope scripts. Functions that used start-continue-stop states/flags have been simplify to using their device-specific flag for starting the 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
2018-05-08 Updated status enquiry function to include several bytes associates with the current state of the device
2018-05-08 Created a function called set-to-idle, which closes or terminates any function on the stethoscope and send the device to an idle state
2018-05-09 Created a new function for multichannels recoridng on the stethoscope. This will allow users to record the audio from the microphone and the speakers to proof/validate simulations are triggered corre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
    [DeviceSpecificFunctions.h, TeensyAudio.h, parseBtByte.h, protocol.h]
2018-05-09 Completed writing start, continue and stop functions that can manage a multi channel recording environment. Testing failed. Culprit may lie within the "File" object which was created to be iteratible.
    [DeviceSpecificFunctions.h, Stethoscope.ino]
2018-05-09 Reverted to using invidual calls for recording channels. The test worked.
    [DeviceSpecificFunctions.h]
2018-05-09 Completed the custom recording for multiple channels modifications to the main stethoscoep arduino code
2018-05-09 Added the new state variables to the display state function to document state changes on the device.
2018-05-10 Began playing with filters to improve the sound quality of the stethoscope
2018-05-10 Added a low pass filter to the mic to speaker path/line to eliminate much of the ambient noise
    [TeensyAudio.h, states.h]
2018-05-13 Currently torubleshooting the latest version of the simulation function. Everything seemed to be working until the switchmode was changed to 6, which had to occur in order to let the continue blendin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
2018-05-13 Muted most print statements to verify the script its functioning as expected.
2018-05-13 Moved the variable call for the simulation overlay file to be defined globally and eliminated the switch call to 0 from within the recording function.
2018-05-13 Through the implementation of the AudioNoInterrupts() functions, the program is currently capable of performing all expected tasks. Currently having a problem with a clicking sound that does not seem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
    [SimulationFunctions.h]
2018-05-13 The audio interrupts are the solution to the file writing curruption, but do not affect the switching sound around the continue-recording blending function. Eliminating one task (like recording for i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
    [DeviceSpecificFunctions.h, SimulationFunctions.h]
2018-05-13 Made modifications in an attempt to suppress the clicking sound but efforts seem useless. When eliminating the continue-recording function alltogether, the blending functions are muted. This may be o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
    [DeviceSpecificFunctions.h, SimulationFunctions.h, states.h]
2018-05-13 Given the results of the de-construction approach, a new branch was created to polish the working approach of calling the functions directly. This revealed that the noise is caused by the continue re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
    [DeviceSpecificFunctions.h, SimulationFunctions.h]
2018-05-13 Created a set gains function to adjust gains related to the playback/overlay audio file. Also created a separate blending function to mitigate the effects of the switch mode function embedded within 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
2018-05-15 Created a set gains function that responds to the calls of switch 0 and also takes an input mode to prepare gains in accordance to a specific function.
2018-05-15 Moved the set gains function, also removed said function from the main loop. Finally integrated the set to idle function. Updated the SD cad on STET002.
2018-07-27 Tested the ability to compare strings to select the correct blending file and function.
    [Config.h, SimulationFunctions.h]
2018-07-31 Listed the remaining files in the playlist structure and created a function that will dramatically simplify the way by which the stethoscope currently blends sound.
2018-07-31 Tested the new function's ability to replace the simulation/blending-specific cae statements.
    [Config.h, parseBtByte.h]
2018-07-31 Made some final modifications and tested playback. Recent "not playing" errors may be related to the length of the file or the inactive rms-modulated payback (I did not have the diaphragm connected).
    [SimulationFunctions.h, parseBtByte.h]
2018-08-01 Modified byte array order to avoid conflict
    [Config.h]
2018-08-29 Add files via upload
    AugmentedSteth single PCB, with other archive stuff for the records
    [AOXIM_V1.1.brd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]
2018-08-29 Check for vFinal. My bad, I thought this went through with the last commit.
    [AugmentedStethoscope_v1.brd, AugmentedStethoscope_v1.sch, AugmentedStethoscope_v2.brd, AugmentedStethoscope_v2.sch, AugmentedStethoscope_v2b.brd, AugmentedStethoscope_v2b.sch, AugmentedStethoscope_v2c.brd, AugmentedStethoscope_v2c.sch]
2019-04-03 Eliminated deprecated, unused or unrelated software
    [K Values for Multiple Magnets.xlsx, diff.txt]
2019-04-03 Organized and cleaned-up the hardware directory
    [AOXIM_V1.1.brd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]
